AntonioVentimiglia/Buddy_Robot/README.md

# Buddy ROS 2 Robot Master Repository

This is the starter GitHub repository for **Buddy**, an autonomous ROS 2 robot using a **Jetson Orin Nano Super**, a **four-wheel differential-drive base**, **2D LiDAR**, and an **RGB-D camera**. It is designed to survive hardware changes while keeping the ROS 2 interfaces, frame tree, simulation, documentation, tests, firmware contracts, and deployment workflow organized from day one.

Two files orient everything:

- [`PROJECT_CONTEXT.md`](PROJECT_CONTEXT.md) — canonical context to paste into AI prompts; includes a "what actually builds today" table.
- [`robot_ws/SIMULATION_START_HERE.md`](robot_ws/SIMULATION_START_HERE.md) — the runbook to start modeling and torque testing right now.

Structural changes should update `PROJECT_CONTEXT.md`.

## Current design baseline

| Area | Baseline |
|---|---|
| Robot name | Buddy |
| Compute | NVIDIA Jetson Orin Nano Super |
| Robot OS target | Ubuntu 24.04 / JetPack 7.x path unless a selected driver forces another choice |
| ROS 2 target | ROS 2 Jazzy first; keep migration notes for Lyrical |
| Drive | Four-wheel differential drive / skid-differential style with left and right wheel groups |
| Sensors | 2D LiDAR, RGB-D camera, IMU, wheel encoders |
| Low-level control | Dedicated drive MCU; Linux/ROS requests motion but MCU enforces watchdog and safety |
| Navigation | Nav2, SLAM Toolbox or AMCL, robot_localization EKF |
| Simulation | Gazebo first; optional Isaac Sim/Isaac ROS path for NVIDIA acceleration |
| Future manipulation | Leave MoveIt 2-compatible arm placeholder until arm is selected |

## How to use this repository first

1. Read `PROJECT_CONTEXT.md`.
2. Requirements are answered in `TODO/01_clarifications_needed.md` and `docs/requirements/buddy_v0_1_requirements.yaml`.
3. Review `docs/system_model/frame_tree.md` and the robot model (`robot_ws/src/buddy_description/urdf/buddy.urdf.xacro`; dimensions live in `design_params.yaml` — edit it and run `python3 tools/build.py`).
4. Choose a ROS 2 + JetPack baseline in `docs/decisions/ADR-0001-ros2-jetpack-baseline.md`.
5. Start simulation before buying major hardware.

## Marking incomplete work

Everything here is in progress — filenames don't say so. When a file is a draft or
its values are unverified, put a one-line `WIP:` note at the top of the file
explaining what's missing. Decisions get locked into ADRs under `docs/decisions/`
when made; that's the signal a topic is settled, not a filename suffix.

## Repository map

```text
buddy_ros2_robot/
  PROJECT_CONTEXT.md              Canonical AI/project context
  TODO/                           Next steps, clarifications, milestone plans
  docs/                           Architecture, requirements, interfaces, power, safety, decisions
  docs/system_model/              How it fits together — start at system_integration.md
  docs/research/                  Research folders, created only when research starts
  docs/analysis/                  First-principles derivations behind every calculation
  docs/portfolio/                 Engineering log + illustrated milestone reports (website source)
  robot_ws/                       ROS 2 workspace skeleton
  firmware/                       MCU firmware architecture and starter scaffolds
  electronics/                    Generated KiCAD schematics (+ PDFs) and datasheets
  devops/                         Jetson setup, containers, systemd, udev, OTA, networking
  tools/                          Build, figures, KiCAD generators, checkers, site generator
  assets/figures/                 Generated figures — every one produced by tools/figures/
```

No diagram in this repository is drawn by hand. Figures are generated by scripts
in `tools/figures/`, schematics by `tools/kicad/`, and both are regenerated by
`python3 tools/build.py`. A hand-made architecture diagram silently contradicted
an ADR for two weeks before it was caught and deleted; see milestone M03.

## Important safety stance

The software here is a development scaffold, not a certified safety system. Physical E-stop, motor enable interruption, power fusing, current limits, watchdogs, and commissioning procedures must be implemented and tested before autonomous operation.
