AntonioVentimiglia/Buddy_Robot/firmware/drive_mcu/README.md

# Drive Mcu

Status: in progress.

Use this folder for embedded code, board notes, build instructions, pin maps, tests, and firmware update strategy.
