AntonioVentimiglia/Buddy_Robot/robot_ws/src/buddy_description/README.md

# buddy_description

Owns the robot description: URDF/Xacro, frames, visual geometry, collision geometry, inertial placeholders, sensor mounts, and future arm placeholder.

The description is the single source of truth for physical frames. Do not duplicate frame offsets in random launch files.
