AntonioVentimiglia/Buddy_Robot/docs/requirements/mission_profile(_IP).md

# Mission Profile

## Current knowns

- Main compute: Jetson Orin Nano Super.
- Drive: four-wheel differential drive.
- Sensors: 2D LiDAR and RGB-D camera.
- ROS 2 compatibility is a primary design goal.

## Fill these before buying hardware

| Domain | Answer |
|---|---|
| Indoor/outdoor/mixed | TBD |
| Floor/terrain | TBD |
| Top speed | TBD |
| Cruise speed | TBD |
| Ramp/threshold | TBD |
| Total mass target | TBD |
| Payload target | TBD |
| Runtime target | TBD |
| Arm required for v1? | TBD |
| Budget range | TBD |
| Robot max footprint | TBD |
| People/pets nearby? | TBD |
| Autonomous vs supervised | TBD |

## Notes

The mission profile drives motor torque, battery Wh, LiDAR range, camera mounting, Nav2 speed limits, base footprint, and safety architecture.
