AntonioVentimiglia/Buddy_Robot/docs/portfolio/log/2026-07.md

---
title: Engineering Log — July 2026
date: 2026-07-01
type: log
tags: [mechanical, electrical, firmware, process]
summary: Repo consolidation; drive motor, wheel, power, bus, and sensor decisions (ADR-0003 to 0007); drive stack and firmware built and host-tested; system integration drawn and machine-checked; drivetrain ordered; fabrication and arm approach chosen (ADR-0008, ADR-0009).
---

# Engineering Log — July 2026

> Entries before 2026-07-11 are reconstructed from git history and are brief by
> nature; same-day logging starts 2026-07-11.

## 2026-07-01 — June sign-off *(reconstructed)*
**Tags:** process
- Closed out June: repo scaffold, URDF model working in RViz, Gazebo sim with
  diff-drive + 2D LiDAR bridged, first torque sweep tool written.

## 2026-07-02 — BOM recovery *(reconstructed)*
**Tags:** process, failure
- BOM spreadsheet had to be recovered (`bom recovery`, commit 61925a9). Lesson:
  binary xlsx in git has no meaningful diffs — a corrupted or clobbered save
  loses history. Mitigation going forward: commit after every BOM edit.

## 2026-07-03 — Purchased bench power supply *(reconstructed)*
**Tags:** purchase
- Bench power supply bought and logged in `docs/financials/Buddy_BOM.xlsx`
  (commit 9196f51). Enables current-limited first power-up per the safety TODO.

## 2026-07-06 — Purchased Jetson peripherals *(reconstructed)*
**Tags:** purchase
- Adapters, HDMI cables, thumb drive for Jetson Orin Nano Super bring-up
  (commit 462d194). Jetson is flashed and running JetPack/Ubuntu.

## 2026-07-11 — Repo declutter, motor sizing, and ADR-0003
**Tags:** calc, decision, process
- **Declutter:** cut the repo from 227 to 106 tracked files — deleted ~19
  template-only research folders, 7 stub ROS packages, duplicate requirements
  files. Removed the `(_IP)` filename convention entirely (files are always in
  progress; the suffix broke path references). Drafts now carry an in-file
  `WIP:` note; an ADR marks a topic settled.
- **Motor sizing (calc):** built the per-wheel torque envelope for the 20 kg
  skid-steer base (r = 0.06 m, 4 driven wheels). Key finding: **pivot-in-place
  tire scrub on carpet sets the stall requirement** — 2.9–3.8 N·m/wheel at
  μ = 0.6–0.8, well above the worst straight-line case (1.47 N·m at 5° ramp +
  0.5 m/s² with SF 2.0). The existing `torque_sweep.py` didn't model scrub;
  derived it from the resisting yaw moment about the pivot center.
  Figure: `assets/figures/torque_envelope.svg`.
- **Decision:** 4× goBILDA 5203 Yellow Jacket 26.9:1 (223 RPM, 3.73 N·m stall,
  $54.99 ea) — the only shortlisted motor clearing the pivot band. Pololu 37D
  (2.65 N·m) and DDSM115 hub servos (2.0 N·m) fall inside/below it. Recorded in
  `docs/decisions/ADR-0003-drive-motor-selection.md` (Proposed; purchase pending).
- **Tension logged:** $220 of the $300–600 budget on motors collides with
  LiDAR + RGB-D + battery (design conflict #4). Fallback documented: cut gross
  mass toward ~10 kg and rerun with JGB37-520-class motors.
- **Portfolio system established** (this log, milestone reports, figures-as-code
  convention in `docs/portfolio/README.md`). Milestone report M01 written.
- **Wheel selection (decision + calc):** caught that the 0.06 m wheel radius used
  in sizing was an unsourced URDF placeholder. goBILDA traction wheels max out at
  96 mm; selected **4× Hogback 96 mm** (crowned tread purpose-built to reduce
  skid-steer scrub — directly attacks our dominant load case) + 8 mm REX hubs,
  ~$76 all-in (ADR-0004). At r = 0.048 m: design case 1.47 → 1.18 N·m, pivot band
  2.29–3.05 N·m → 22% stall margin at μ = 0.8 (was marginal). Trade accepted:
  **ground-clearance requirement amended 0.05 → 0.038 m** (the 0.05 was a round
  guess; indoor thresholds are 5–20 mm). Cascade: requirements yaml, URDF params
  (incl. base_center_z 0.10 → 0.088 to keep axle height = wheel radius so sim
  wheels touch ground), envelope figure + CSV regenerated, derivation doc
  substitutions redone, M01 postscript. Lesson: a "placeholder" number that feeds
  a real decision isn't a placeholder — audit inputs for unsourced values.
- **Parametric build system (process):** identified that design values lived in
  five hand-synced places (requirements yaml, xacro, CLI defaults, figure
  constants, markdown prose) — today's wheel change required manually chasing
  every substitution, and a hand-rounding error (3.06 vs computed 3.05 N·m) had
  already crept in. Built the fix: `design_params.yaml` (choices/assumptions) +
  requirements yaml (requirements, no overlap) → `buddy_calcs/` loader+equations
  → everything downstream is generated by `python3 tools/build.py`: the URDF
  params file (now marked GENERATED), the derivation docs (marimo notebooks in
  `docs/analysis/*.py` whose substituted numbers are computed, exported to the
  committed `.md`), both figures, and the sweep CSV. Verified end-to-end: changed
  SF 2.0 → 1.5, one build propagated 1.18 → 0.88 N·m through derivation, figure
  legend, annotation, and CSV; reverted cleanly; consecutive builds are
  byte-identical. Bonus catch: the FBD had been drawing wheels at the stale
  120 mm — parametrization fixed it automatically. Lesson: numbers that appear
  in more than one file need a build step, not discipline.
- **Derivation convention added** (same day, after review): calculations must be
  presented as checkable derivations — governing equations, symbol tables, numeric
  substitution, units check, limits of validity — so a reviewing engineer can
  verify every number by hand. First instance:
  `docs/analysis/drive_torque_and_pivot_scrub.md`, with a two-panel free-body
  diagram figure (`tools/figures/plot_drive_fbd.py`) covering the ramp FBD and the
  pivot moment balance.

## 2026-07-14 — Battery re-sized for the future dual-arm version
**Tags:** decision, calc
- **Correction of course:** the roadmap adds two 6-DOF arms in a later version
  sharing the main battery; an 8 Ah pack bought for v0.1 would be wasted money
  when the arms arrive. Amended ADR-0005 (still Proposed — nothing purchased,
  so an in-place dated amendment, not a new ADR).
- **Provision, explicitly a placeholder:** 12 XM430-class joints, ≤4 loaded per
  arm at once → +45 W average, +10 A peak, recorded in
  `design_params.yaml → power.future_arms` with instructions to replace with
  real servo specs at arm selection.
- **New spec:** designed peak 37 → **47 A** incl. arm branch → BMS ≥ **50 A**,
  main fuse 50 → **60 A** slow-blow, bus wiring upgraded to 8 AWG, future arm
  branch separately fused at 15 A. Battery ≥ 8 Ah → **≥ 14 Ah (~155 Wh),
  $100–140** — C-rate still mild (3.4C). Bonus: v0.1 runtime at expected load
  grows to ~90+ min. Mass +0.6–0.8 kg absorbed by the 20 kg ceiling — no drive
  re-sizing triggered (checked, not assumed: the envelope uses the ceiling).
- Cascade: requirements yaml (`manipulation_future`), power model + build
  validators (now check BMS/fuse against the arms-inclusive peak), notebook,
  figure (new "+ dual arms" scenario bar and third energy stack), shopping list
  (total ~$540 → **~$590**), PROJECT_CONTEXT, site chips.

## 2026-07-16 — Motor datasheet arrives, catches a 4× odometry bug
**Tags:** failure, calc, build
- **The bug:** the motor spec sheet states *"Encoder Shaft: 28 Pulses per
  Rotation (7 Cycles)"* — 28/7 = 4, so goBILDA's "pulses" are **already
  4x-decoded quadrature counts**. My code, built from the vendor web page's
  "751.8 PPR", multiplied by 4 again → 3007 counts/rev instead of **753.2**.
  Odometry would have reported ~¼ of true distance. On bench day this would
  have looked like a baffling scale error and cost hours; the datasheet cost
  ten minutes.
- **Root cause is naming, not arithmetic:** "PPR" is ambiguous (pulses? cycles?
  edges?) and I resolved it the conventional way instead of checking. Fix
  renames the parameter to `encoder_counts_per_rev_output` so the unit is
  unambiguous at every call site, with the datasheet quote in the comment.
  Corrected in design_params, the generated firmware header, `base_core.py`,
  both test suites, and the mock MCU's wheel model; all 6 suites still green.
- **Caught a vendor error too:** the sheet's companion "(134.4 Cycles)" is
  inconsistent — 753.2/134.4 = 5.6, not 4, and 134.4 = 7 × **19.2**, the *other*
  gear ratio's number. Our value (28 × 26.9 = 753.2) is self-consistent. Flagged
  in the yaml comment; empirical check added to bench day (one wheel revolution
  by hand, read the count).
- **Confirmed by the same sheet:** no-load current **0.25 A** — exactly the
  estimate the power budget assumed and flagged for measurement (ADR-0005). One
  assumption closed, no change needed.
- **Harness gap found while purchasing:** connectors/cabling for the motors were
  never in the shopping list. Wrote `docs/system_model/wiring_harness.md`
  documenting goBILDA's MH-FC/FH-MC gender notation, the motor's two interfaces
  (3.5 mm bullets FH-MC for power; 4-pos JST XH FH-MC for the encoder), and —
  most importantly — that **motor power goes to the driver, never to the
  Nucleo**. Correct part is the *breakout* encoder cable (4 individual Dupont
  leads), because our encoder pins are deliberately non-adjacent across
  TIM2/3/4/8. +$56 to the cart (now ~$646, or ~$741 with Phase A sensors).

## 2026-07-28 — Integration figures, and the first build that ran on Windows
**Tags:** build, test, process, failure
- **The trigger:** integration knowledge was spread across six correct documents
  and one wrong drawing. `assets/diagrams/system_architecture_mermaid.md` — hand
  made, not generated — still showed a **CAN bridge** two weeks after ADR-0006
  chose USB serial. Deleted. A drawing that isn't generated is already wrong;
  it just hasn't been caught yet.
- **Six generated figures** (`tools/figures/plot_{ros_graph, control_safety_loop,
  power_one_line, interconnect, fault_state_machine, startup_sequence}.py`),
  indexed from the new `docs/system_model/system_integration.md` and published as
  milestone M03. Matplotlib does Buddy's quantitative figures well and block
  diagrams badly, so they render through a new dependency-free SVG kit
  (`tools/figures/blockdiagram.py`); the palette moved to one file
  (`tools/figures/palette.py`) that all nine figures now import — verified
  output-neutral by regenerating the three existing figures byte-for-byte first.
- **Topology became data:** `docs/system_model/integration_map.yaml` owns what
  connects to what and is forbidden from holding a number that `design_params.yaml`
  or the requirements yaml already owns; it writes references
  (`param:power.protection.main_fuse_a`) that resolve at draw time. The fuse
  rating on the power diagram isn't a copy of the fuse rating — it *is* the fuse
  rating.
- **`tools/check_integration_map.py`** runs first in every build and asserts the
  map against `pin_map.md` ↔ `pins.h`, the KiCAD net table, `drive_protocol.md`
  (states + fault bits) and the topics `ros_bridge_node.py` really creates.
  Tested by breaking things on purpose: flipping one INA pin `PB0`→`PB9` fired
  two independent checks; renaming a fault bit fired a third. It also caught a
  real inconsistency on first run — the map claimed a `/diagnostics` publisher
  that doesn't exist yet, so the check now tolerates `planned` topics being
  absent from code while still refusing to let code publish anything the diagram
  omits.
- **Layout is audited, not eyeballed.** Every figure bounds-checks each box,
  label and edge tag against the canvas and each other before writing; caught 8
  collisions in the first ROS graph and 19 in the first interconnect. Cross-checked
  against real browser font metrics afterwards: 417 text elements, zero collisions.
- **Second KiCAD sheet** (`electronics/KiCAD/system_wiring/`): pack, protection
  chain, rails, Jetson↔MCU↔sensors, future arm branch — 16 nets asserted by
  `check_system_wiring.py` against an independently written expectation. Drawing
  it surfaced two facts no document had stated: the **LD19 is not on the 5 V
  rail** (the D300 USB adapter draws its 0.9 W from a Jetson port, so it sits in
  the Jetson's budget), and the **BNO086 is on a different 3.3 V rail** from the
  encoders (`+3V3_JETSON`, the 40-pin header, vs the Nucleo LDO's `+3V3`).
  Corrected in the map.
- **Three real bugs in the existing toolchain, all found by running it here:**
  (1) `tools/build.py` had never been run on Windows and died on the `η` in a
  derivation — `write_text` defaults to cp1252; every generator now writes UTF-8
  with explicit LF, plus a `.gitattributes` so `core.autocrlf` stops rewriting
  the generated tree. It also emitted `docs\analysis\...` backslash paths into a
  committed file. (2) The schematic generator used `uuid4()`, so regenerating an
  unchanged schematic produced 498 lines of meaningless diff; UUIDs are now
  `uuid5` of a stable key, and kicad-cli's wall-clock `/CreationDate` in the PDF
  export is rewritten to the sheet date (same byte length, xref stays valid).
  (3) `check_drive_wiring.py` hard-coded the macOS `kicad-cli` path, so the
  "machine-checked, not visually claimed" property was true on exactly one
  laptop — it now resolves across all three platforms.
- Consecutive builds are byte-identical again, now including the schematics and
  their PDFs. Lesson: "reproducible" is a claim about the machines you have
  actually run it on, and this repo had one.
- Not verified here: the C protocol/state-machine tests and the pty-backed mock
  MCU need a POSIX toolchain (no `cc`, no `termios` on Windows). The pure-Python
  suites — 9 protocol + 8 base_core — pass.

## 2026-07-31 — Drivetrain ordered; fabrication method chosen; the arms get real
**Tags:** purchase, decision, calc
- **Drivetrain ordered** (goBILDA): 4× 5203 motors, 4× Hogback wheels, 4× Sonic
  hubs, encoder breakout cables, motor power cables, M4 hardware — ~$359 with
  shipping, recorded in `Buddy_BOM.xlsx` as *Order Pending*. The 4× Pololu
  VNH5019 carriers and 2× NUCLEO-G474RE already arrived. ADR-0003/0004 are now
  decisions with money behind them and should flip Proposed → Accepted.
  *(First CAD assemblies — motor, wheel, Sonic hub, drivetrain — were committed
  the same session; that work still needs its own narrative entry from the
  author, including why the sub-assembly split was chosen.)*
- **Fabrication method decided (ADR-0008): in-house FDM printing**, and the
  printer is **QIDI Plus 4** (~$800). The interesting part is which requirement
  turned out to be binding. The instinct is to score printers on build volume
  and price; the actual driver was **chamber temperature**. Motor mounts bolt
  directly to gearboxes running at the 8 A design limit, and PLA's glass
  transition is ~60 °C — a mount that creeps there doesn't break visibly, it
  relaxes, and the symptom that reaches the operator is **drifting odometry**,
  which gets misdiagnosed as a firmware bug for weeks. That pushes the material
  to ASA/PA-CF, which at a ~280 mm part length needs an *actively* heated
  chamber, not a passive enclosure. That single requirement eliminated the
  popular defaults: the Bambu P1S (best measured accuracy in the set at
  ±0.05 mm) and the Elegoo Centauri Carbon are both passively enclosed, and the
  Prusa CORE One — the most open and best-supported machine considered — has the
  *smallest* build area of the five at the highest price.
- **Reversal worth recording:** the Centauri Carbon ($299) was the right
  recommendation an hour earlier, under a hard budget ceiling. When the owner
  scoped the printer as a capital tool for future projects, the ceiling lifted
  and the ranking inverted. Lesson: a recommendation is only as durable as the
  constraint that produced it — worth naming the constraint out loud so the
  reversal is legible instead of looking like inconsistency.
- **Arms decided (ADR-0009): printed structure + hobby servos**, forced by cost —
  Dynamixel XM430-class would be ~$3,100 for twelve joints against a $2000
  programme budget. **This decision reached back into the power architecture.**
  ADR-0005's whole argument was that stall current is a *designed ceiling*
  because the VNH5019s have an adjustable current limit. Hobby servos have no
  such limit — commanded into a stall they draw stall current until something
  else stops them. Bounded it: manipulation average ~39 W (the 45 W placeholder
  survives), realistic 8-joint peak ~11 A at the bus (10 A placeholder marginal),
  all-12-stalled ~29 A — which would have pushed the designed peak from 47 A to
  ~66 A, past both the ≥50 A BMS and the 60 A fuse.
- **The protection chain already contained it, by accident of good design.** The
  15 A arm branch fuse from the 2026-07-14 amendment caps the branch at ~166 W,
  sitting deliberately between the realistic peak (holds) and the all-stalled
  case (blows). So ADR-0005 survives unmodified and **the imminent battery
  purchase is not blocked** — checked, not assumed. What changed is the *role* of
  that fuse: specified as a backstop for actuators that limited their own
  current, it is now the primary limiter. Safe, but not graceful — the drive side
  degrades by quietly limiting torque, the arm side by blowing a fuse and
  demanding a human. Flagged for a current-limited servo rail at arm build time.
- **Budget reframed** (`design_conflicts.md` #4, revised): the $300–600 band is
  superseded by a $2000 programme budget split into pots — $1,173.85 spent,
  $826.15 left, v0.1 needs ~$355 of it, future-phase (OAK-D + arm servos)
  ~$380–560. v0.1 closes comfortably; the roadmap closes only at the low end of
  the servo estimate. That makes the ADR-0009 open item — evaluate Feetech
  STS/SCS bus servos, which would buy back both position feedback and current
  limiting at near hobby-servo cost — a budget decision as much as a technical one.
- Research doc: `docs/research/hardware/fabrication/printer_selection.md`
  (six requirements derived from the robot, five candidates scored, known
  limitations of the selected machine listed rather than discovered later —
  including that its effective *heated* build height is ~268 mm, not 280).

## 2026-07-31 — Jetson bring-up: ROS 2 on the robot computer, drive stack verified
**Tags:** build, test, failure
- **The zero-hardware milestone is real, on the actual robot computer.** ROS 2
  Jazzy installed, workspace built (3 packages, 5.5 s), and the full chain
  proven: `/cmd_vel` → `buddy_base` bridge → real protocol bytes over a pty →
  mock MCU state machine + wheel model → telemetry → `/odom`. **9/9 checks pass.**
- **Numbers, not vibes:** commanded 0.2 m/s, reported steady-state velocity
  0.2008 m/s (**0.4% error**), independently measured over a timed window
  0.1952 m/s (**2.4%**). Commands stopped → position held, confirming the 200 ms
  watchdog (REQ_SAFE_002) end-to-end through the real bridge rather than a unit test.
- **First time the C toolchain ran anywhere but a dev machine.** The 07-15 entry
  noted the C protocol and state-machine tests couldn't run on Windows (no `cc`,
  no `termios`). On the Jetson they run: 11 C protocol, 20 C state machine,
  Python protocol, mock MCU self-test, 8 BaseCore units, 5 integration — all green.
- **Failure 1 — the setup script had never been run end to end.** It opens with
  `set -euo pipefail`, and ROS's own `/opt/ros/jazzy/setup.bash` reads variables
  it never sets (`AMENT_TRACE_SETUP_FILES`). Under `-u` that is fatal, so the
  script died at step 3/6 — *after* a 15-minute apt install, on the first line
  that costs nothing. Fixed with `set +u` around both `source` calls. Lesson: a
  script that has only ever been read is not a script that works, and the
  expensive steps passing tells you nothing about the cheap ones.
- **Failure 2 — Python buffering hid the handoff.** The mock MCU prints its pty
  path; with stdout redirected to a file that print is block-buffered and never
  arrives, so the verification script couldn't find the device it had just
  created. `python3 -u`. Invisible in interactive use, fatal in automation.
- **Failure 3 — the test was wrong, not the code.** First verification run
  reported the robot travelling 0.378 m where 0.2 m/s × 3 s predicts 0.6 — a 37%
  shortfall that looks exactly like a scaling bug, which is the same *shape* as
  the 4× encoder bug found on 07-16. It wasn't: node startup, DDS discovery, the
  SAFE_IDLE→ARMED→ACTIVE transition and the mock's wheel ramp all landed inside
  the measurement window. Rewritten to measure **steady-state velocity** instead
  of integrating across startup, which is both the correct measurement and the
  one that actually says whether the stack tracks its command. Worth recording
  because the tempting move was to go hunting in the kinematics.
- **Automation path built** (`devops/jetson/`): key-based SSH from the Mac, plus
  `sudoers-buddy-setup` — a narrow NOPASSWD drop-in scoped to apt/dpkg/locale-gen/
  rosdep/udevadm with `cp` **pinned** to `/etc/udev/rules.d/`, since an unpinned
  `sudo cp` is arbitrary root file-write and would make the other restrictions
  decorative. The file states plainly that it is not a security boundary — `apt
  install` as root is arbitrary code execution by definition — and can be deleted
  after bring-up, because nothing in the daily workflow needs sudo at all.
- Verifying the NOPASSWD paths *before* the long run caught `udevadm` at
  `/usr/bin/`, not `/usr/sbin/` as assumed. A wrong path there doesn't error —
  sudo silently falls through to prompting, which hangs an unattended run.
- **New artifact:** `devops/jetson/verify_zero_hardware_stack.sh` — the milestone
  as a repeatable script with written pass/fail criteria, rather than three
  hand-driven terminals and an eyeball.

## 2026-07-31 — First silicon: firmware flashed, link verified, 0.49 ms round trip
**Tags:** build, test, failure
- **The firmware runs on real hardware for the first time.** Flashed a
  NUCLEO-G474RE from the Jetson over SSH; `st-flash` verified the write. The
  board self-identified as `STM32G47x_G48x`, 512 KiB flash, ST-LINK **V3J16** —
  vendor:product `0483:374e`, exactly what `99-buddy-robot.rules` assumed, so
  `/dev/buddy_drive_mcu` appeared on first plug-in. One assumption that could
  have been wrong wasn't.
- **Link verified end to end** (`devops/jetson/verify_drive_mcu_link.py`, 13/13):
  telemetry at **102.0 Hz** against a 100 Hz target, **zero CRC errors** and zero
  version errors across 204 frames, state `SAFE_IDLE` with no fault bits, wheels
  reporting zero velocity, and PING→PONG **10/10** reporting firmware v0.1.0 /
  protocol v1 — the version gate of `drive_protocol.md` rule 4 exercised for real.
- **First measured latency on the real link: 0.48–0.61 ms round trip**, median
  0.49 ms. The 07-14 interface verification argued this on paper (18× bandwidth
  margin); measured, the margin against the 200 ms watchdog is ~330×. The
  watchdog budget is not remotely the constraint on this bus.
- **Build reproducibility, unplanned evidence:** the committed `firmware.bin`
  was dated 14 July. A clean rebuild three weeks later on a different machine
  produced a byte-identical image (md5 `b768497a…`). Checked before flashing
  rather than trusting the timestamp — flashing a stale image is a bug that
  hides for days.
- **Failure — a permissions trap that would have been misdiagnosed.** The udev
  rule creates `/dev/buddy_drive_mcu` as `root:dialout 0660`, and the `dialout`
  group on the Jetson was **empty** — `venti` was not a member. The symlink
  exists, the rule "works", and the bridge still cannot open the port. The
  obvious suspect would have been the udev rule, which was innocent. Fixed with
  `usermod -aG dialout`; worth knowing that a fresh SSH session is needed for the
  new group to apply.
- **Failure — my test was wrong, not the firmware. Again.** First run reported
  PING→PONG 0/10 and I went hunting in the HAL: checked `volatile` on the RX ring
  (correct), noticed there is no `HAL_UART_ErrorCallback` and theorised that a
  DTR transient on port-open latched a UART error and killed RX permanently.
  A controlled experiment — quiesce DTR/RTS, reset the MCU with the port already
  open, re-ping — returned 5/5 both before and after, refuting it. The actual
  cause: my script asserted `PONG.seq == PING.seq`, but `drive_protocol.md`
  defines the PONG payload as `{fw_major, fw_minor, fw_patch, protocol_version}`
  and specifies **no seq echo**; the MCU stamps its own TX seq, and only
  `TELEMETRY.cmd_seq_echo` echoes, only for CMD_VEL. The firmware was right and
  the spec was unambiguous.
- **Second-order bug in the same test:** the "round trip" initially measured
  99–111 ms, which looked like a real latency problem. It was `ser.read(512)`
  refusing to return until 512 bytes accumulated — at ~4.7 kB/s of telemetry
  that is ~110 ms of pure measurement artefact. Reading `in_waiting` instead
  moved the number to 0.49 ms. **Two tests in one day where the instrument, not
  the system, was the thing under test.** The pattern to internalise: when a
  measurement disagrees with a design estimate by two orders of magnitude,
  suspect the measurement first — it is cheaper to falsify.
- Note for the bench phase: the `HAL_UART_ErrorCallback` gap is real even though
  it was not today's bug. Nothing currently re-arms `HAL_UART_Receive_IT` after
  a UART error, so a single overrun would silently kill RX while telemetry keeps
  streaming — a failure that looks like a dead Jetson link, not a dead MCU.
  Logged as a bench TODO rather than fixed blind.
- **New artifacts:** `tools/flash/flash_drive_mcu.sh` (was a stub that printed
  "not configured yet" and exited 1) and `devops/jetson/verify_drive_mcu_link.py`.

## 2026-07-31 — Bridge meets real silicon, and finds a latched-fault bug
**Tags:** build, test, failure, decision
- **Closed the gap I had left open:** the `buddy_base` bridge had only ever
  talked to `mock_mcu.py` over a pty. Pointed the same code path at
  `/dev/buddy_drive_mcu` (`devops/jetson/verify_bridge_vs_real_mcu.sh`).
  Safe by construction — no drivers wired, no motors attached, and the MCU
  refuses motion without an explicit ARM.
- **The full chain works on hardware:** bridge opens the real port, parses real
  telemetry into `/odom`, `/joint_states` and `/battery_state` (1.26 V — a real
  ADC reading, not a mock constant), auto-arms off a genuine `SAFE_IDLE`, and
  the MCU reports **`cmd_seq_echo=71`** — seventy-one CMD_VEL frames that began
  life as ROS `/cmd_vel` messages, accepted by the real state machine. The
  200 ms watchdog then fired on silicon: `fault_bits=0x0002`, REQ_SAFE_002
  verified on hardware rather than in a unit test.
- **Bug 1 — the bridge cried wolf.** It logged every `FAULT_EVT` at WARN as
  "MCU fault event". But `FAULT_EVT` is emitted on *any* state transition —
  `main.c` sends it whenever state or fault_bits change, and
  `drive_protocol.md` documents it as "on transition". The first real run
  duly reported two "faults" that were the benign `SAFE_IDLE → ARMED` handover
  with `bits=0x0000`. Left alone, the bench phase would have been wall-to-wall
  spurious warnings and a real fault would have been invisible among them. Now
  WARN only when a bit is actually set, INFO otherwise. Fixed a second defect in
  the same handler: it logged `core.state_name()` — whatever the last telemetry
  frame happened to say — rather than the state carried in the event payload
  that the transition was actually about.
- **Bug 2 — a real firmware bug, and the interesting one.** `sm_tick` carries
  the comment *"per state_machine.md: timeout is a recoverable stop, not a
  latched fault"* and correctly drops to `SAFE_IDLE` instead of `FAULT`. But it
  sets `BP_FAULT_CMD_TIMEOUT` and **nothing anywhere clears it**:
  `MODE_CLEAR_FAULT` only acts in `FAULT` state, which the watchdog
  deliberately never enters. The bit was unreachable for the life of the MCU.
  The implementation contradicted its own stated design intent, one line above.
- **How it surfaced:** the second hardware run inherited `0x0002` from the
  first and reported it in ARMED *and* ACTIVE. A stale flag from a previous
  session was masquerading as a live fault — and a genuinely new timeout would
  have been indistinguishable from it. This is invisible to host tests that
  start from `sm_init`, which is precisely why it survived 20 passing state
  machine checks.
- **The codebase already knew the right answer:** `sm_set_estop` clears its own
  bit when the condition goes away. CMD_TIMEOUT now follows the same pattern —
  cleared on re-ARM and on any accepted CMD_VEL. Only that bit; real faults
  still demand CLEAR_FAULT from FAULT state.
- **Written test-first:** added four host assertions, confirmed **2 failed**
  against the old firmware, then fixed. `mock_mcu.py` had the identical bug —
  it mirrors the C state machine faithfully, defect included — so it got the
  same fix, keeping the two implementations in lockstep. That lockstep is the
  whole reason the protocol was implemented twice.
- **Verified by repetition, not assertion:** ran the hardware check twice in
  succession. Run 1 leaves a watchdog timeout behind; run 2 came up clean
  (`0 faults`, reached ARMED). Firmware 16400 → 16416 bytes.
- **A third instrument correction:** `verify_drive_mcu_link.py` asserted
  `fault_bits == 0`, which quietly assumed a freshly booted MCU and failed the
  moment it ran after a bridge session. Now masks the recoverable CMD_TIMEOUT
  and fails only on latching bits — encoding the distinction the firmware fix
  made explicit.
- Final state: MCU link 13/13, bridge-vs-real-MCU 13/13 (twice), zero-hardware
  stack 9/9, full host suite green on the Jetson.

## 2026-07-16 — KiCAD harness schematic, generated and machine-verified
**Tags:** build, test
- **Wiring diagram as code:** `tools/kicad/gen_drive_wiring.py` emits a native
  KiCAD 10 schematic (`electronics/KiCAD/drive_mcu_wiring/`) — NUCLEO-G474RE
  block, 4× VNH5019, 4× motor/encoder units, Vbat divider, power/E-stop notes —
  with connectivity by named nets matching `pin_map.md`/`pins.h`. Opens in the
  user's KiCAD; renders via `kicad-cli`.
- **Connectivity is checked mechanically, not visually:**
  `tools/kicad/check_drive_wiring.py` exports the netlist through kicad-cli and
  asserts all 43 nets pin-by-pin (every MCU pin to its exact driver/encoder
  counterpart, power rails counted). Two real bugs found and fixed in the
  process: caption offsets landing near neighboring blocks, and off-grid pin
  endpoints (instance origins must sit on KiCAD's 1.27 mm grid).
- The schematic is documentation of the harness; electrical *spec* checks
  (voltage levels, AF mappings, ADC ranges) live in
  `docs/system_model/electrical_interfaces.md` — the drawing now gives them a
  buildable wiring reference.

## 2026-07-15 — The drive stack exists end-to-end (no hardware yet)
**Tags:** build, test, decision
- **`buddy_base` bridge written and proven:** all drive logic (skid-steer
  kinematics with ratio-preserving clamp, diff-drive odometry with midpoint
  integration, keep-alive pacing against the 200 ms MCU watchdog) is plain
  Python with no ROS dependency — 8 unit tests + **5 end-to-end integration
  tests driving the mock MCU through real protocol bytes**: straight-line and
  pivot odometry within model tolerance, watchdog stop with bounded runaway
  distance, E-stop visibility, joint states. The rclpy node is a thin shell;
  `base.launch.py` is now real. Deleted the stale CAN/C++ stubs and configs
  that carried wrong geometry (0.08 m wheels — exactly the drift the
  parametric system exists to kill; geometry now flows from `design_params.yaml`).
- **Testing found a real bug:** the mock MCU used wall-clock time for its
  watchdog, so simulated-time tests couldn't trip it. Now takes an injectable
  clock — the same pattern the C state machine had from the start. Lesson: the
  C core got it right *because* it was designed for host testing; the mock was
  written casually and paid for it.
- **Sensors selected, phased (ADR-0007):** LD19 LiDAR ($70, 0.9 W, ToF 12 m) +
  BNO086 IMU ($25, on-chip fusion) join the current order (+$90 → ~$685);
  OAK-D Lite ($140, 4.5 W, on-camera VPU) selected but deferred until
  perception work starts. Budget extension past the $300–600 band made
  explicit in the ADR. The power reserves held without amendment — the
  reserve mechanism did its job.
- **Jetson bring-up scripted** (`devops/jetson/setup_ros2_jazzy.sh`, idempotent):
  ROS 2 Jazzy + workspace build + the full host test suite, ending at the
  **zero-hardware milestone** — teleop keyboard → bridge → mock MCU → `/odom`
  on the actual robot computer. Real udev rule written for the ST-LINK VCP
  (0483:374e → `/dev/buddy_drive_mcu`).
- **M02 milestone report** published: the stall-current story, the validator
  catch, and the size-once-for-the-arms battery decision.

## 2026-07-14 — Interface verification, drive protocol v1, firmware compiles
**Tags:** calc, decision, build, test
- **Interface verification** (`docs/system_model/electrical_interfaces.md`):
  purchases proceed on the assumption motors ↔ VNH5019 ↔ G474 ↔ Jetson
  interoperate — now checked signal-by-signal with numbers instead of hope.
  Highlights: everything is 3.3 V-native (VNH5019 logic high ≥ 2.1 V), zero
  level shifters; TIM1 @ 170 MHz → 20 kHz PWM at ~13-bit resolution; CS gives
  1.12 V at the 8 A limit into a 12-bit ADC (~5.8 mA/LSB); VCP link has 18×
  bandwidth margin; MCU powered from the 5 V rail so both failure directions
  (Jetson dies / MCU dies) land safe. Five-item bench-verify list for what
  paper can't close.
- **ADR-0006 — bus decision:** USB serial via the Nucleo's ST-LINK VCP for
  v0.1 (zero hardware, huge margin); CAN-FD reserved for the arm era (G474 has
  FDCAN on-chip); micro-ROS rejected because the MCU must stay safe with ROS
  entirely absent.
- **Drive protocol v1, implemented twice on purpose:** framed 0xB5DD +
  CRC-16/CCITT-FALSE + seq + version; CMD_VEL/CMD_MODE/PING/TELEMETRY/PONG/
  FAULT_EVT; 200 ms watchdog rule (REQ_SAFE_002); E-stop dominance; MCU-side
  velocity clamp. C implementation (no deps, no allocation, resynchronizing
  parser) compiles into firmware AND host tests; Python mirror for the Jetson
  bridge; **golden vectors assert byte-identity between the two** — the ends
  cannot drift silently.
- **Mock MCU** (`mock_mcu.py`): full state machine + watchdog + wheel model
  over a pty — the future `buddy_base` bridge node gets integration-tested with
  zero hardware. 10 behavioral self-tests pass.
- **Firmware compiles for the real target:** pure-C safety state machine
  (host-tested: 19 checks incl. "E-stop release does not auto-run" and "cannot
  arm out of FAULT"), HAL layer per the new pin map (4 hardware quadrature
  timers, TIM1 PWM, CS ADC, fault GPIOs), superloop with telemetry at 100 Hz.
  PlatformIO/GCC for NUCLEO-G474RE: **16.4 kB flash, 1.5 kB RAM**. Firmware
  constants (`buddy_config.h`) are GENERATED from `design_params.yaml` — the
  parametric build now reaches into the firmware.
- One command runs every host-side test: `tools/run_protocol_tests.sh`
  (C protocol, C state machine, Python protocol, mock MCU — all green).
- Lesson: writing the protocol twice with golden vectors caught nothing today
  *because it can't* — mismatches are structurally impossible to ship. That's
  the point.

## 2026-07-12 — Power budget: the stall-current fear, resolved by design
**Tags:** calc, decision
- **The fear:** 4 × 9.2 A motor stall + Jetson + sensors looked like an
  impossible/unaffordable battery worst case. **The resolution:** stall current
  is a fault condition, not an operating point — the motor drivers' adjustable
  current limit turns the worst case into a *chosen* number. Designed ceiling:
  8 A/motor → 37 A bus peak including system loads, vs 42 A unlimited fault.
- **The validator earned its keep on first run:** the initial 7 A limit choice
  only allowed 2.81 N·m — below the 3.05 N·m worst-case carpet pivot. Raised to
  8 A (allows 3.23 N·m) and scaled the protection chain to match (BMS ≥ 40 A,
  fuse 50 A). `tools/build.py` now enforces these inequalities on every build
  (`buddy_calcs/power.py::validate`).
- **Architecture (ADR-0005):** 3S Li-ion + BMS (chosen over RC LiPo for the
  hardware protection layer near people/pets); motors direct on the bus; Jetson
  behind a regulated 12 V buck (dev kit input 9–20 V verified — sag can't brown
  out compute); protection chain driver-limit → BMS → 50 A slow-blow fuse → E-stop.
- **Capacity:** unchosen camera/LiDAR carry ≤ 5 W *reserved allocations* that
  become hard selection constraints. Allocation model (everything at full
  reserve): 66 W avg → 92 Wh → **3S ≥ 8 Ah, ~$60–100** guarantees the 60-min
  requirement; expected usage (46 W) gives ~85 min. Peak is a mild ≈ 4.5C —
  the peaks never drove the sizing; runtime did.
- New parametric analysis: `design_params.yaml` power section +
  `buddy_calcs/power.py` + `docs/analysis/power_budget_and_battery.py` notebook +
  `assets/figures/power_budget.svg`. Superseded and deleted the all-TBD
  `docs/hardware/power_budget.yaml` and `tools/calculators/battery_sizing.py`.
- **Carried forward:** motor driver selection now has a HARD requirement —
  adjustable ~8 A per-channel current limit (in-driver or current-sense + MCU).
- **Motor driver shortlist (decision pending purchase):** compared RoboClaw
  2x15A (premium, $260), TB67H420FTG (hardware current chop but 3.4 A continuous
  — only 10% over the 3.1 A sustained case, thermally thin), BTS7960 ($35,
  crude), and **4× Pololu VNH5019 carriers (~$100, recommended)** — 12 A/30 A
  per channel, 140 mV/A current-sense into the G474's ADCs for the 8 A firmware
  limit, hardware overcurrent backstop. The firmware limit sits on the safety
  path → mandatory bench verification before rolling. Bonus: the dual-VNH5019
  Arduino shield stacks directly on the NUCLEO-G474RE for the first bench loop.
  Doc: `docs/research/hardware/electronics/motor_drivers/driver_selection.md`.
- **Purchasing checklist created:** `docs/financials/SHOPPING_LIST_v0_1.md`
  (temporary) — full v0.1 cart ≈ **$540** of the $300–600 budget: drivetrain
  $292, electronics + power $249. Conflict #4 quantified, trim options listed.
- **Portfolio website generator built** (`tools/site/build_site.py`, runs inside
  the parametric build): renders milestones, analyses (KaTeX math), ADRs, and
  this log into `site/` — 10 pages, engineering-clean light design sharing the
  figure palette so figures blend into the page, landing-page spec chips
  **computed from `design_params.yaml` at build time** (the website is itself a
  parametric artifact). Verified in-browser: zero KaTeX errors across 13 display
  equations, all figures load, no broken links (unmapped repo docs render as
  code, not 404s). Kept private/local for now; deterministic + committed like
  all generated artifacts.
