AntonioVentimiglia/Buddy_Robot/devops/networking/network_plan.md

# Networking Plan

- Robot hostname: `buddy.local` placeholder.
- Use SSH keys.
- Keep a local recovery account.
- Use wired Ethernet for development when possible.
- Wi-Fi is convenience, not the only recovery path.
- Decide whether VPN/private remote access is allowed.
- Keep ROS_DOMAIN_ID fixed per robot/test environment.
