AntonioVentimiglia/Buddy_Robot/robot_ws/src/buddy_simulation/docs/simulation_plan.md

# Simulation Plan

## Level 1 - Interface simulation

Nodes start, topics connect, TF tree exists.

## Level 2 - Physics simulation

Differential drive moves, simulated LiDAR publishes scan, odometry publishes.

## Level 3 - Navigation simulation

Nav2 completes a route in a simple world.

## Level 4 - Hardware-in-the-loop later

Real MCU is connected while robot motion is constrained or simulated.
