AntonioVentimiglia/Buddy_Robot/docs/portfolio/README.md

# Portfolio System

**The website is live-generated:** `tools/site/build_site.py` (runs inside
`python3 tools/build.py`) renders this folder + `docs/analysis/` + the ADRs into
`site/` — engineering-clean light design matching the figures, KaTeX math,
landing-page spec chips computed from `design_params.yaml`. View locally:
`python3 -m http.server -d site 8137`. Publish decision deferred (portable
relative paths; GitHub Pages-ready).

This folder is the source material for the eventual project website and for
defending Buddy's engineering decisions in interviews. The repo stays private;
the website is **generated from these documents**, so their structure is a
contract — keep it consistent.

## The three layers

| Layer | Where | Cadence | Purpose |
|---|---|---|---|
| **Engineering log** | `log/YYYY-MM.md` | every working session | Raw record: what was done, numbers, failures, lessons. 5–10 lines per entry. This is where "tell me about a time something didn't work" gets answered. |
| **Milestone reports** | `milestones/Mxx-*.md` | one per completed phase | Polished, illustrated narrative synthesized from log entries + ADRs + research docs. These become website pages. |
| **Decision/analysis records** | `docs/decisions/` (ADRs), `docs/research/` | as decisions happen | The technical substance the other two layers cite. Not duplicated here. |

## Rules

1. **Every milestone report gets at least one figure**, and every figure is
   generated by a script in `tools/figures/` — never a screenshot of a hand-made
   chart. Figures regenerate from the repo; a figure that can't be regenerated
   from committed code doesn't go in a report.
2. **Every calculation states its assumptions with justification and a
   sensitivity note** ("if μ is 0.8 instead of 0.6, the requirement is 3.8 N·m —
   still covered"). Interviewers attack assumptions, not arithmetic.
3. **Every calculation is presented as a derivation, not a result.** A reviewing
   engineer must be able to check every number with a calculator: governing
   equations from first principles (with a free-body or kinematic diagram where
   forces/moments are involved), a symbol table with units and the values used,
   the numeric substitution written out, a units check, and explicit **limits of
   validity** (the conditions under which the model stops being true). Derivations
   live in `docs/analysis/`, one document per calculation domain; research docs
   and milestone reports *cite* them rather than restate them. The tone target:
   explaining the process, never presenting a number to be taken on faith.
   **Mechanically**, each derivation is a marimo notebook (`docs/analysis/*.py`)
   whose substituted numbers are computed from `design_params.yaml` +
   the requirements yaml via `buddy_calcs` — explore live with
   `marimo edit <notebook>.py`; `python3 tools/build.py` exports the committed
   `.md` (a generated artifact) and regenerates figures, the URDF params, and
   data files in the same pass. A derivation can never silently disagree with
   the parameters again.
4. **Physical evidence is captured the day it happens** in
   `assets/evidence/YYYY-MM-DD_slug/` (photos, videos, scope traces, test CSVs).
   Hardware states are unrepeatable — the bare chassis can't be re-photographed
   after it's wired.
5. **Log entries are written same-day**, even if only three lines. Backfilled
   entries are marked as reconstructions.
6. **Frontmatter on every log file and milestone report** (website generation
   depends on it):

```yaml
---
title: <page title>
date: YYYY-MM-DD
type: milestone | log
tags: [mechanical, process, embedded, testing, ...]
summary: <one sentence for index/card pages>
figures: [assets/figures/<name>.svg]   # milestones only
---
```

## Log entry format

```markdown
## YYYY-MM-DD — Short title
**Tags:** calc | decision | build | test | failure | purchase
- What was done, with numbers.
- What went wrong / what was learned (most valuable line — don't skip).
- Links: ADRs, research docs, evidence folders, commits.
```
