AntonioVentimiglia/Buddy_Robot/docs/financials/Buddy_BOM.xlsx

Descriptive Part Name | Total Qty Required | Qty Purchased | Unit Cost | Total Spent | Part Status | Date Ordered | Date Received | Vendor | Vendor’s Part # | Manuf. | Manuf. Part # | Key Features / Specs | URL | Shipping Link / ID | More Info | Legend
Jetson Orin Nano Super | 1 | 1 | $268.30 | $268.30 | Received/Delivered | 2026-06-28 | 2026-07-06 | NVIDIA | - | NVIDIA | - | SBC | https://marketplace.nvidia.com/en-us/enterprise/robotics-edge/jetson-orin-nano-super-developer-kit/ | https://marketplace.nvidia.com/en-us/account/?action=order_status | > AI Performance: 67 TOPS > GPU: NVIDIA Ampere architecture with 1024 CUDA cores and 32 tensor cores > Power: 7W-25W |  | = Cell calculated from Formula
KingSpec NVMe SSD | 1 | - | $56.97 |  | N/A |  |  | Amazon | B0D1R7HDJF | KingSpec |  | SSD 256GB, M.2 NVMe Gen3x4 SSD 2280 | https://www.amazon.com/KingSpec-256GB-NVMe-Gen3x4-2280/dp/B0D1R7HDJF |  | Up to 2400MB/s, Internal Solid State Drive with 3D NAND Flash, Compatible with Desktop and Laptop
Soldering Iron Kit Electronics, 14-in-1 60w Adjustable Temperature Soldering Iron, 5pcs Soldering Iron Tips, Desoldering Pump, Tweezers, Stand, Solder, PU Carry Bag | 1 | 1 | $24.99 | $24.99 | Received/Delivered | 2026-06-29 | 2026-07-02 |  |  |  |  |  | https://vilros.com/products/vilros-soldering-iron-kit-electronics-14-in-1-60w-adjustable-temperature-soldering-iron-with-on-off-switch-5pcs-soldering-iron-tip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 | https://vilros.com/checkouts/cn/hWNDusRMj6K85SvbVymcHVwX/en-us/thank-you?skip_shop_pay=true |  | Purchase Status Drop Down List Options
MicroSD Card (32 GB) | 1 | - |  |  | Already Owned |  |  |  |  |  |  |  |  |  |  | Already Owned
MicroSD to USB-B to USB-A | 1 | - |  |  | Already Owned |  |  |  |  |  |  |  |  |  |  | Received/Delivered
DC Power Supply | 1 | 1 | $48.48 | $48.48 | Received/Delivered | 2026-07-03 | 2026-07-04 | Amazon | B0DDPVDWPZ | JESVERTY |  | DC Power Supply Variable, 0-32V 0-10A | https://www.amazon.com/dp/B0DDPVDWPZ?smid=A1ESSXTD1TYBDH&ref_=chk_typ_imgToDp&th=1 |  | DC Power Supply Variable, 0-32V 0-10A Switching Bench Power Supply with 20W USB & Type-C Quick-Charge, Encoder Corase & Fine Adjustment Knob, Output Switch, 4-Digit LED Display - SPS-3010V | Partially Ordered
HDMI Cables, 6ft | 1 | 3 | $4.58 | $13.73 | Received/Delivered | 2026-07-06 |  | Amazon | B01H7M6YKI |  |  | 3-Pack, 6 ft, High-Speed 4K@60Hz HDMI 2.0 Cord, 18Gbps, 2160p, 48 bit | https://www.amazon.com/dp/B01H7M6YKI?ref=ppx_yo2ov_dt_b_fed_asin_title&th=1 |  | Amazon Basics HDMI Cable, 3-Pack, 6 ft, High-Speed 4K@60Hz HDMI 2.0 Cord, 18Gbps, 2160p, 48 bit, Compatible with TV/PS5/Xbox/Roku/Blu-ray, Ethernet Ready, Black | In Shipping
USB & USBC Flashdrive, 128 GB | 1 | 1 | $14.41 | $14.41 | Received/Delivered | 2026-07-06 |  | Amazon | B088LMS5VV |  |  | Flash Drive 128GB 2 in 1 OTG USB 3.0/Type C | Amazon.com: KOOTION USB C Flash Drive 128GB 2 in 1 OTG USB 3.0/Type C Thumb Drive Dual Drive USB C Memory Stick for Smartphone/Laptop/Tablet/PC - 128G, Blue : Electronics |  | KOOTION USB C Flash Drive 128GB 2 in 1 OTG USB 3.0/Type C Thumb Drive Dual Drive USB C Memory Stick for Smartphone/Laptop/Tablet/PC - 128G, Blue | Blocked by Testing
Display Port to HDMI Adapter | 1 | 1 | $7.99 | $7.99 | Received/Delivered | 2026-07-06 |  | Amazon | B0CYHB956B |  |  | Display Port to HDMI 4K Adapter | Amazon.com: UANTIN Display Port to HDMI 4K Adapter | Braided DP DisplayPort Male to HDMI Female Uni-Directional Converter for PC Dell HP AMD NVIDIA Laptop HDTV Monitor and Other Passive : Electronics |  | Display Port to HDMI 4K Adapter | Braided DP DisplayPort Male to HDMI Female Uni-Directional Converter for PC Dell HP AMD NVIDIA Laptop HDTV Monitor and Other Passive | To be Ordered
USB female to USB C male adapter | 1 | 4 | $1.75 | $6.99 | Received/Delivered | 2026-07-06 |  | Amazon | B0DY5RJGCR |  |  | USB C to USB Adapter 4 Pack | Amazon.com: AVMAX USB C to USB Adapter 4 Pack,USBC Male to USB 3.0 Female OTG Adapter,Type C Male to A Female 3.0 OTG Adapter for Apple iPhone 16 15,Flash Thumb Drive,Mac,iPad,Samsung Galaxy : Electronics |  | AVMAX USB C to USB Adapter 4 Pack,USBC Male to USB 3.0 Female OTG Adapter,Type C Male to A Female 3.0 OTG Adapter for Apple iPhone 16 15,Flash Thumb Drive,Mac,iPad,Samsung Galaxy | Order Pending
NUCLEO-G474RE | 1 | 2 | $24.48 | $48.97 | Received/Delivered | 2026-07-25 |  | STMelectronics |  |  |  |  |  | UPS GROUND: 1Z7759450324444260 |  | Need Replacement
TP-Link Deco AXE5400 Tri-Band WiFi 6E Mesh System(Deco XE75) | 1 | 1 | $294.96 | $294.96 | Received/Delivered | 2026-07-28 | 2026-07-28 | Best Buy | SKU: 6508223 |  |  | Tri-band | https://www.bestbuy.com/product/tp-link-deco-xe75-pro-axe5400-tri-band-wi-fi-6e-whole-home-mesh-system-3-pack-white/J39QK2QCVK/sku/6508223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 |  | TP-Link - Deco XE75 Pro AXE5400 Tri-Band Wi-Fi 6E Whole Home Mesh System (3-Pack) - White | To be Manufactured
Planetary Gear Motor | 4 | 4 | $61.30 | $245.20 | Order Pending | 2026-07-29 |  | goBILDA | SKU: 5203-2402-0027 |  |  |  | https://www.gobilda.com/5203-series-yellow-jacket-planetary-gear-motor-26-9-1-ratio-24mm-length-8mm-rex-shaft-223-rpm-3-3-5v-encoder/ | Order Num: 200129494 | 5203 Series Yellow Jacket Planetary Gear Motor (26.9:1 Ratio, 24mm Length 8mm REX® Shaft, 223 RPM, 3.3 - 5V Encoder) | N/A
Encoder Cables: 4-Pos JST XH [MH-FC] to 4 x 1-Pos TJC8 [MH-FC] | 4 | 4 | $4.45 | $17.79 | Order Pending | 2026-07-29 |  | goBILDA | SKU: 3801-0919-0300 |  |  |  | https://www.gobilda.com/encoder-breakout-cable-4-pos-jst-xh-mh-fc-to-4-x-1-pos-tjc8-mh-fc-300mm-length/ | Order Num: 200129494 | Encoder Breakout Cable (4-Pos JST XH [MH-FC] to 4 x 1-Pos TJC8 [MH-FC], 300mm Length)
Motor to Driver Power Cables | 4 | 4 | $2.78 | $11.10 | Order Pending | 2026-07-29 |  | goBILDA | SKU: 3800-0013-0300 |  |  |  | https://www.gobilda.com/3-5mm-bullet-lead-mh-fc-300mm-length/ | Order Num: 200129494 | 3.5mm Bullet Lead (MH-FC, 300mm Length)
Wheel Hub (Sonic) | 4 | 4 | $8.91 | $35.63 | Order Pending | 2026-07-29 |  | goBILDA | SKU: 1309-0016-4008 |  |  |  | https://www.gobilda.com/1309-series-sonic-hub-8mm-rex-bore/ | Order Num: 200129494 | 1309 Series Sonic Hub (8mm REX® Bore)
M4 Socket 12mm (24 pack) | 1 | 1 | $4.78 | $4.78 | Order Pending | 2026-07-29 |  | goBILDA | SKU: 2822-0004-0012 |  |  |  | https://www.gobilda.com/premium-m4-socket-head-thread-locking-screw-12mm-length-25-pack/ | Order Num: 200129494 | Premium M4 Socket Head Thread-Locking Screw (12mm Length) - 25 Pack
Traction Wheel | 4 | 4 | $11.14 | $44.55 | Order Pending | 2026-07-29 |  | goBILDA | SKU: 3626-0014-0096 |  |  |  | https://www.gobilda.com/hogback-traction-wheel-96mm-diameter-50a-durometer/ | Order Num: 200129494 | Hogback Traction Wheel (96mm Diameter, 50A Durometer)
Motor Driver Carrier | 4 | 4 | $21.50 | $85.98 | Received/Delivered | 2026-07-29 |  | Pololu | Item Number: 1451 |  |  |  | https://www.pololu.com/product/1451 | Salesorder 1J592793 | VNH5019 Motor Driver Carrier: operates from 5.5 to 24 V and can deliver a continuous 12 A (30 A peak). It works with 2.5 to 5 V logic levels, supports ultrasonic (up to 20 kHz) PWM, and features current sense feedback (an analog voltage proportional to the motor current). Along with built-in protection against reverse-voltage, over-voltage, under-voltage, over-temperature, and over-current
 |  |  |  |  | N/A
 |  |  |  |  | N/A
 |  |  |  |  | N/A |  |  |  |  |  |  |  |  |  |  | Total Budget: | $2000.00
 |  |  |  |  | N/A |  |  |  |  |  |  |  |  |  |  | Total Spent: | $1173.85
Switch |  |  |  |  | N/A |  |  |  |  |  |  |  |  |  |  | Remainder | $826.15
Relays |  |  |  |  | N/A
Fuses |  |  |  |  | N/A
3D Printer |  |  |  |  | N/A
Voltage Regulators |  |  |  |  | N/A
Buck Converters |  |  |  |  | N/A
E-Stop Button |  |  |  |  | N/A
 |  |  |  |  | N/A
 |  |  |  |  | N/A
Oscilloscope |  |  |  |  | N/A
Solder Fan |  |  |  |  | N/A
 |  |  |  |  | N/A
