AntonioVentimiglia/Buddy_Robot/CAD/M4 Socket Head Thread-Locking Screw (12mm Length).step

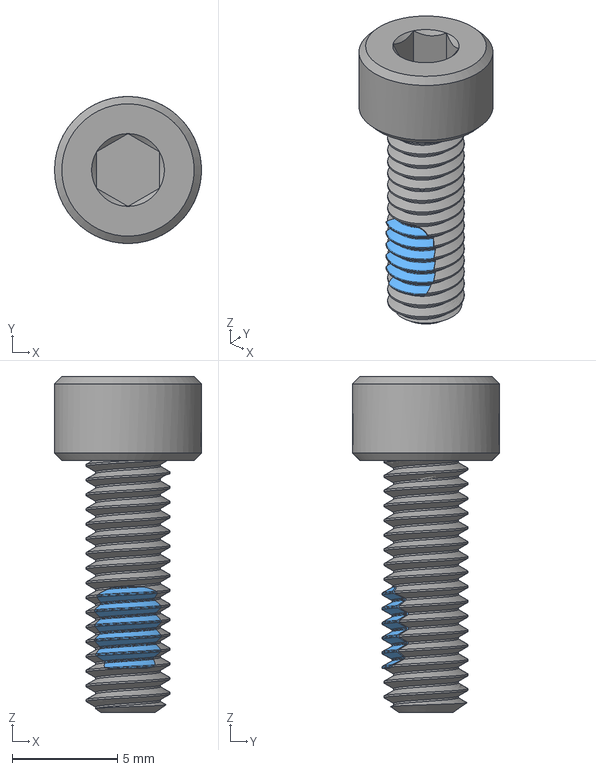
[picture p1: CAD file, 2026-07-30]
CAD/M4 Socket Head Thread-Locking Screw (12mm Length).step
7.00 x 7.00 x 16.0 mm
