AntonioVentimiglia/Buddy_Robot/CAD/Sonic Hub/Sonic Hub.SLDASM

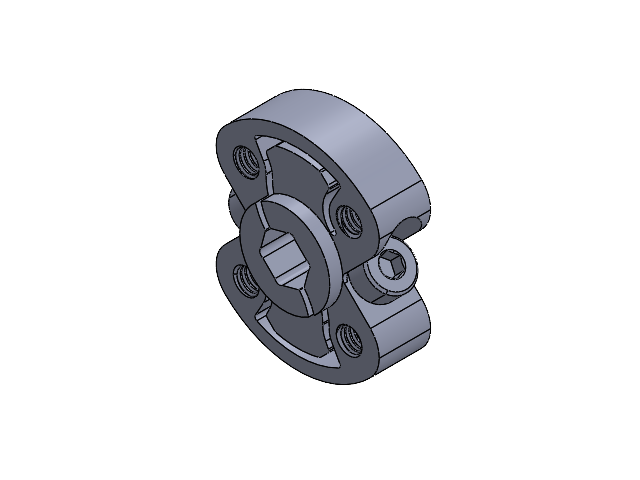
[picture p2: CAD file, 2026-07-30]
CAD/Sonic Hub/Sonic Hub.SLDASM
1309-0016-4008.STEP
2800-0004-0014_90128A207.STEP x 2
