AntonioVentimiglia/Buddy_Robot/electronics/KiCAD/drive_mcu_wiring/drive_mcu_wiring.pdf

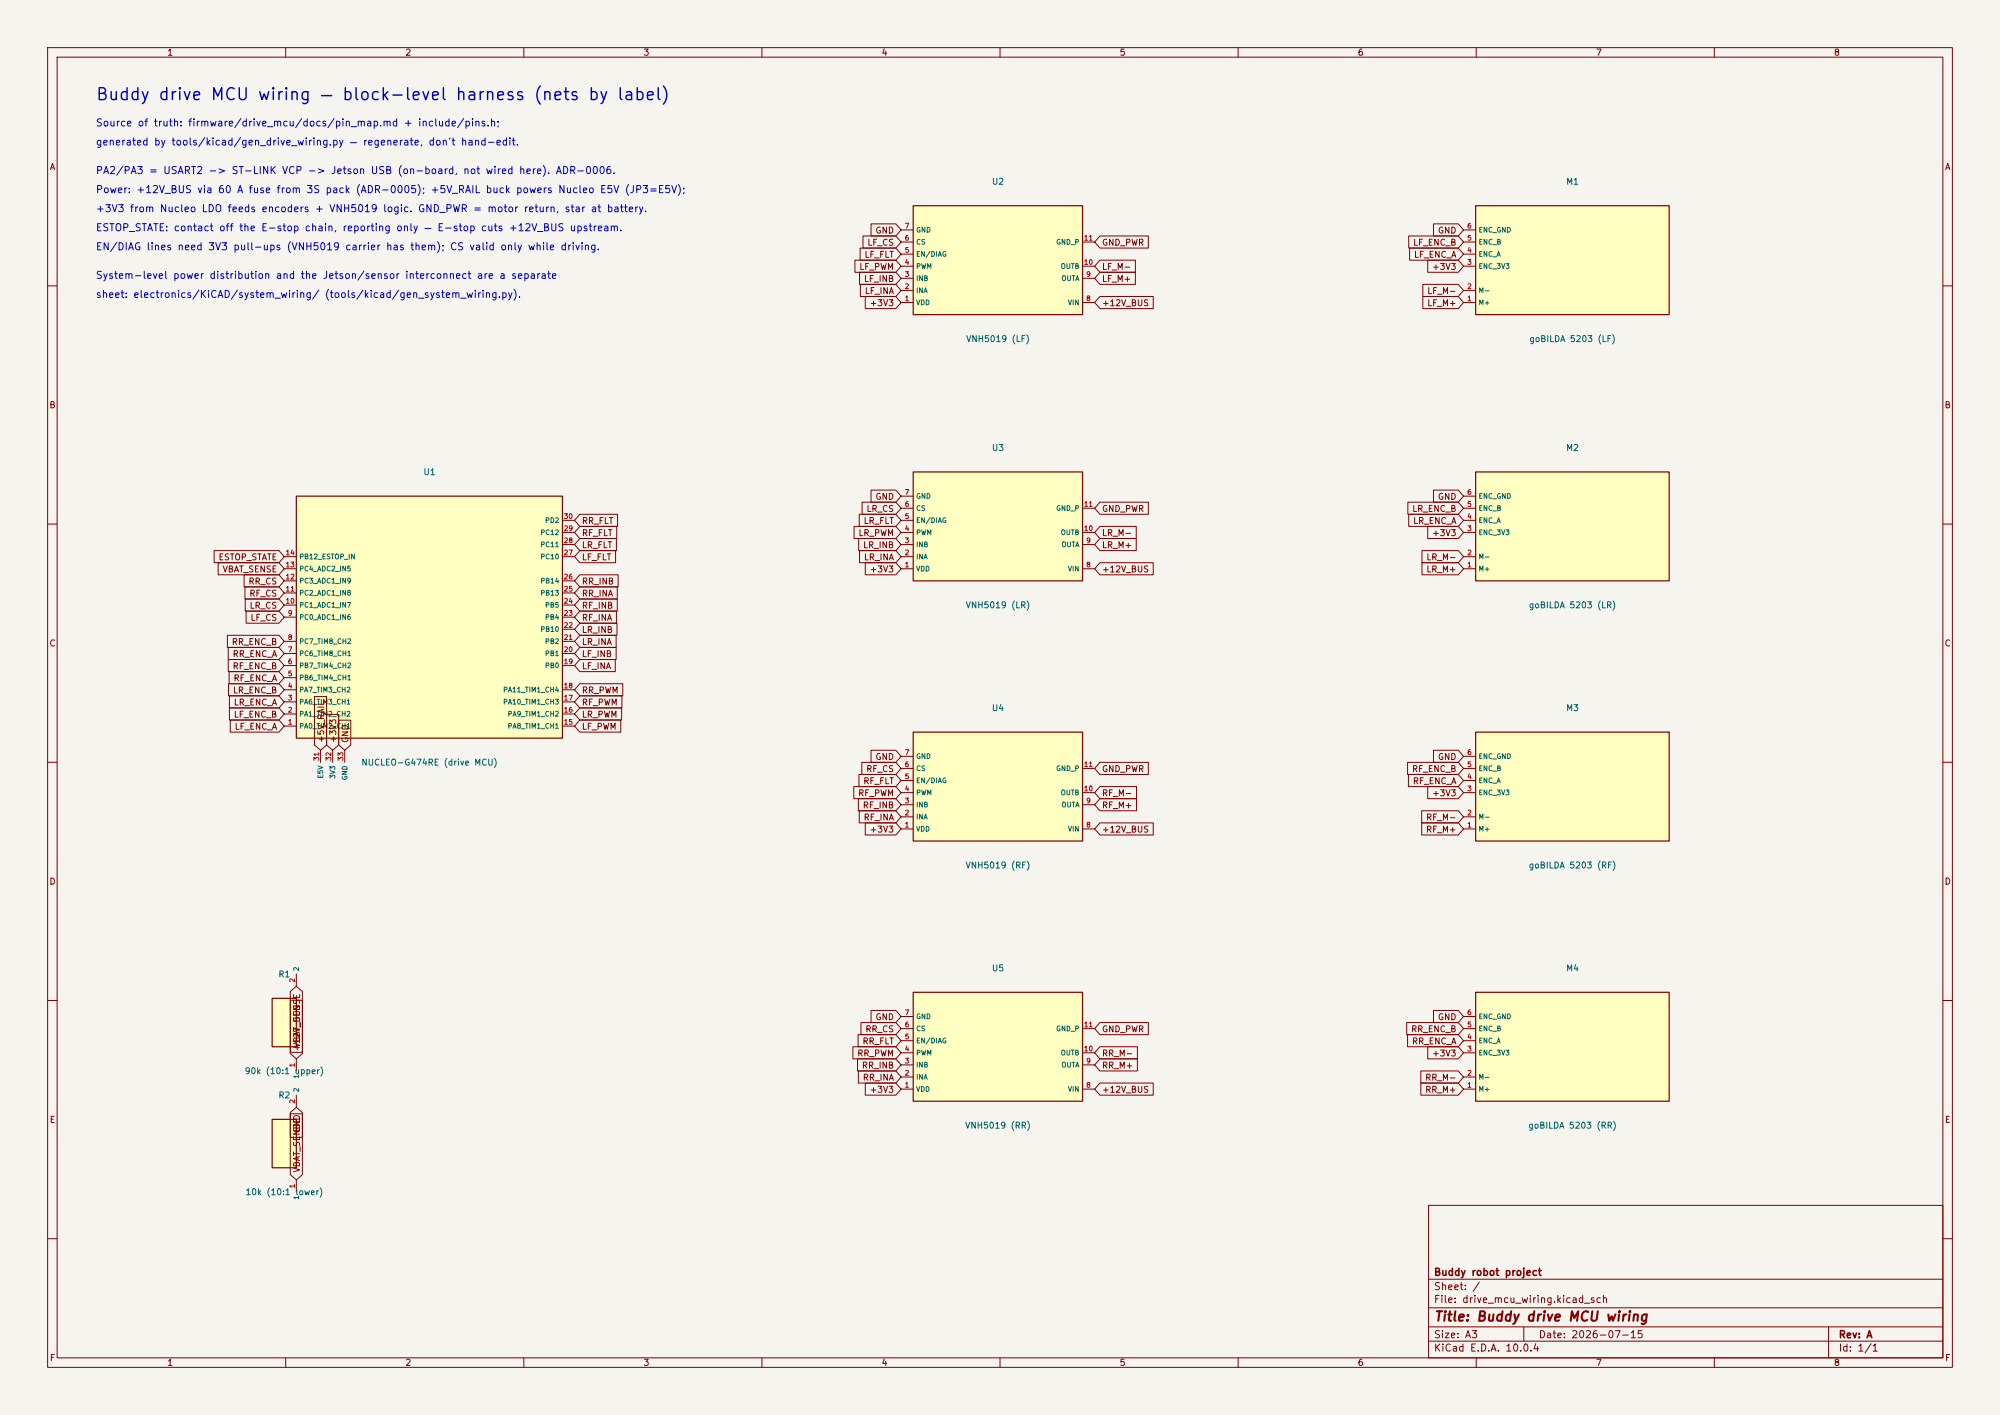
[picture p4: page 1]

Buddy drive MCU wiring — block-level harness (nets by label)

Source of truth: firmware/drive_mcu/docs/pin_map.md + include/pins.h;
generated by tools/kicad/gen_drive_wiring.py — regenerate, don't hand-edit.

PA2/PA3 = USART2 -> ST-LINK VCP -> Jetson USB (on-board, not wired here). ADR-0006.
Power: +12V_BUS via 60 A fuse from 3S pack (ADR-0005); +5V_RAIL buck powers Nucleo E5V (JP3=E5V);
+3V3 from Nucleo LDO feeds encoders + VNH5019 logic. GND_PWR = motor return, star at battery.
ESTOP_STATE: contact off the E-stop chain, reporting only — E-stop cuts +12V_BUS upstream.
EN/DIAG lines need 3V3 pull-ups (VNH5019 carrier has them); CS valid only while driving.

System-level power distribution and the Jetson/sensor interconnect are a separate
sheet: electronics/KiCAD/system_wiring/ (tools/kicad/gen_system_wiring.py).

Sheet: /
File: drive_mcu_wiring.kicad_sch
Title: Buddy drive MCU wiring

Size: A3 | Rev: A
KiCad E.D.A. 10.0.4 | Id: 1/1
