AntonioVentimiglia/Buddy_Robot/electronics/KiCAD/drive_mcu_wiring/drive_mcu_wiring.kicad_sch

## KiCad design electronics/KiCAD/drive_mcu_wiring/drive_mcu_wiring.kicad_sch (2026-07-29, an earlier design)

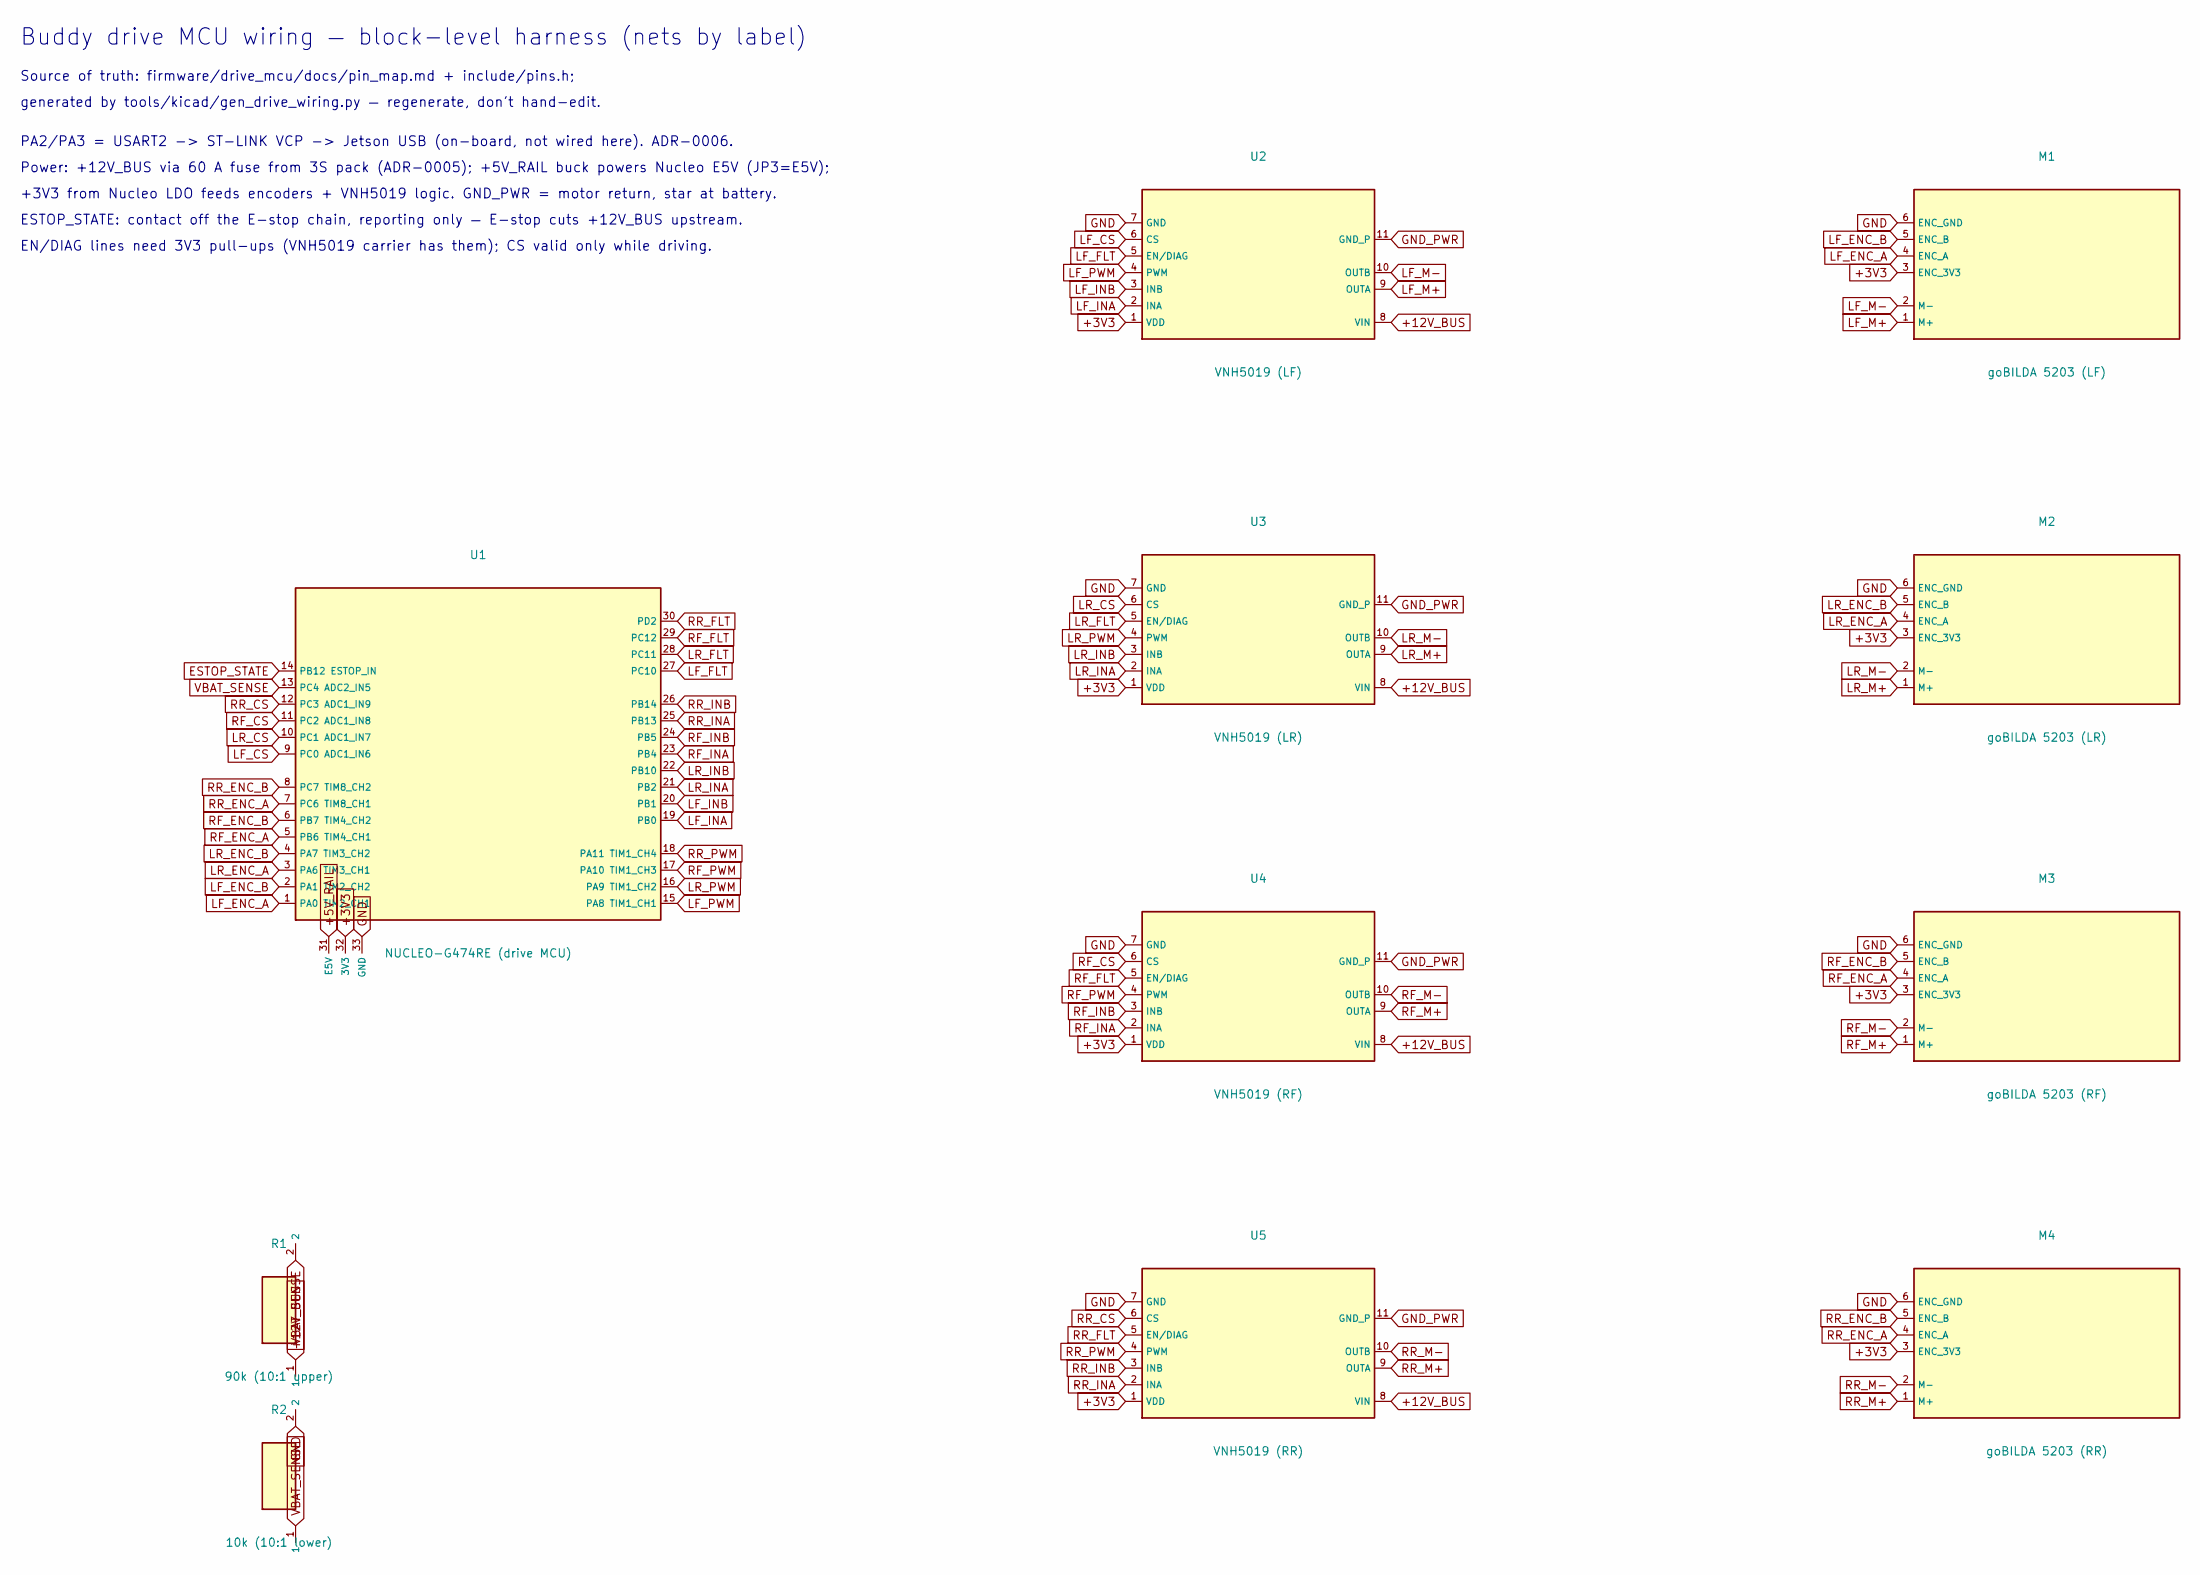
[picture p5: schematic drive_mcu_wiring.kicad_sch]

Parts:
M1: goBILDA 5203 (LF)
M2: goBILDA 5203 (LR)
M3: goBILDA 5203 (RF)
M4: goBILDA 5203 (RR)
R1: 90k (10:1 upper)
R2: 10k (10:1 lower)
U1: NUCLEO-G474RE (drive MCU)
U2: VNH5019 (LF)
U3: VNH5019 (LR)
U4: VNH5019 (RF)
U5: VNH5019 (RR)

Connections:
+3V3: M1.3 (ENC_3V3), M2.3 (ENC_3V3), M3.3 (ENC_3V3), M4.3 (ENC_3V3), U1.32 (3V3), U2.1 (VDD), U3.1 (VDD), U4.1 (VDD), U5.1 (VDD)
+5V_RAIL: U1.31 (E5V)
+12V_BUS: R1.1, U2.8 (VIN), U3.8 (VIN), U4.8 (VIN), U5.8 (VIN)
ESTOP_STATE: U1.14 (PB12 ESTOP_IN)
GND: M1.6 (ENC_GND), M2.6 (ENC_GND), M3.6 (ENC_GND), M4.6 (ENC_GND), R2.2, U1.33 (GND), U2.7 (GND), U3.7 (GND), U4.7 (GND), U5.7 (GND)
GND_PWR: U2.11 (GND_P), U3.11 (GND_P), U4.11 (GND_P), U5.11 (GND_P)
LF_CS: U1.9 (PC0 ADC1_IN6), U2.6 (CS)
LF_ENC_A: M1.4 (ENC_A), U1.1 (PA0 TIM2_CH1)
LF_ENC_B: M1.5 (ENC_B), U1.2 (PA1 TIM2_CH2)
LF_FLT: U1.27 (PC10), U2.5 (EN/DIAG)
LF_INA: U1.19 (PB0), U2.2 (INA)
LF_INB: U1.20 (PB1), U2.3 (INB)
LF_M+: M1.1 (M+), U2.9 (OUTA)
LF_M-: M1.2 (M-), U2.10 (OUTB)
LF_PWM: U1.15 (PA8 TIM1_CH1), U2.4 (PWM)
LR_CS: U1.10 (PC1 ADC1_IN7), U3.6 (CS)
LR_ENC_A: M2.4 (ENC_A), U1.3 (PA6 TIM3_CH1)
LR_ENC_B: M2.5 (ENC_B), U1.4 (PA7 TIM3_CH2)
LR_FLT: U1.28 (PC11), U3.5 (EN/DIAG)
LR_INA: U1.21 (PB2), U3.2 (INA)
LR_INB: U1.22 (PB10), U3.3 (INB)
LR_M+: M2.1 (M+), U3.9 (OUTA)
LR_M-: M2.2 (M-), U3.10 (OUTB)
LR_PWM: U1.16 (PA9 TIM1_CH2), U3.4 (PWM)
RF_CS: U1.11 (PC2 ADC1_IN8), U4.6 (CS)
RF_ENC_A: M3.4 (ENC_A), U1.5 (PB6 TIM4_CH1)
RF_ENC_B: M3.5 (ENC_B), U1.6 (PB7 TIM4_CH2)
RF_FLT: U1.29 (PC12), U4.5 (EN/DIAG)
RF_INA: U1.23 (PB4), U4.2 (INA)
RF_INB: U1.24 (PB5), U4.3 (INB)
RF_M+: M3.1 (M+), U4.9 (OUTA)
RF_M-: M3.2 (M-), U4.10 (OUTB)
RF_PWM: U1.17 (PA10 TIM1_CH3), U4.4 (PWM)
RR_CS: U1.12 (PC3 ADC1_IN9), U5.6 (CS)
RR_ENC_A: M4.4 (ENC_A), U1.7 (PC6 TIM8_CH1)
RR_ENC_B: M4.5 (ENC_B), U1.8 (PC7 TIM8_CH2)
RR_FLT: U1.30 (PD2), U5.5 (EN/DIAG)
RR_INA: U1.25 (PB13), U5.2 (INA)
RR_INB: U1.26 (PB14), U5.3 (INB)
RR_M+: M4.1 (M+), U5.9 (OUTA)
RR_M-: M4.2 (M-), U5.10 (OUTB)
RR_PWM: U1.18 (PA11 TIM1_CH4), U5.4 (PWM)
VBAT_SENSE: R1.2, R2.1, U1.13 (PC4 ADC2_IN5)

Notes on the sheet:
Buddy drive MCU wiring — block-level harness (nets by label)
Source of truth: firmware/drive_mcu/docs/pin_map.md + include/pins.h;
generated by tools/kicad/gen_drive_wiring.py — regenerate, don't hand-edit.
PA2/PA3 = USART2 -> ST-LINK VCP -> Jetson USB (on-board, not wired here). ADR-0006.
Power: +12V_BUS via 60 A fuse from 3S pack (ADR-0005); +5V_RAIL buck powers Nucleo E5V (JP3=E5V);
+3V3 from Nucleo LDO feeds encoders + VNH5019 logic. GND_PWR = motor return, star at battery.
ESTOP_STATE: contact off the E-stop chain, reporting only — E-stop cuts +12V_BUS upstream.
EN/DIAG lines need 3V3 pull-ups (VNH5019 carrier has them); CS valid only while driving.
