AntonioVentimiglia/Buddy_Robot/electronics/KiCAD/system_wiring/system_wiring.kicad_sch

## KiCad design electronics/KiCAD/system_wiring/system_wiring.kicad_sch (2026-08-01, an earlier design)

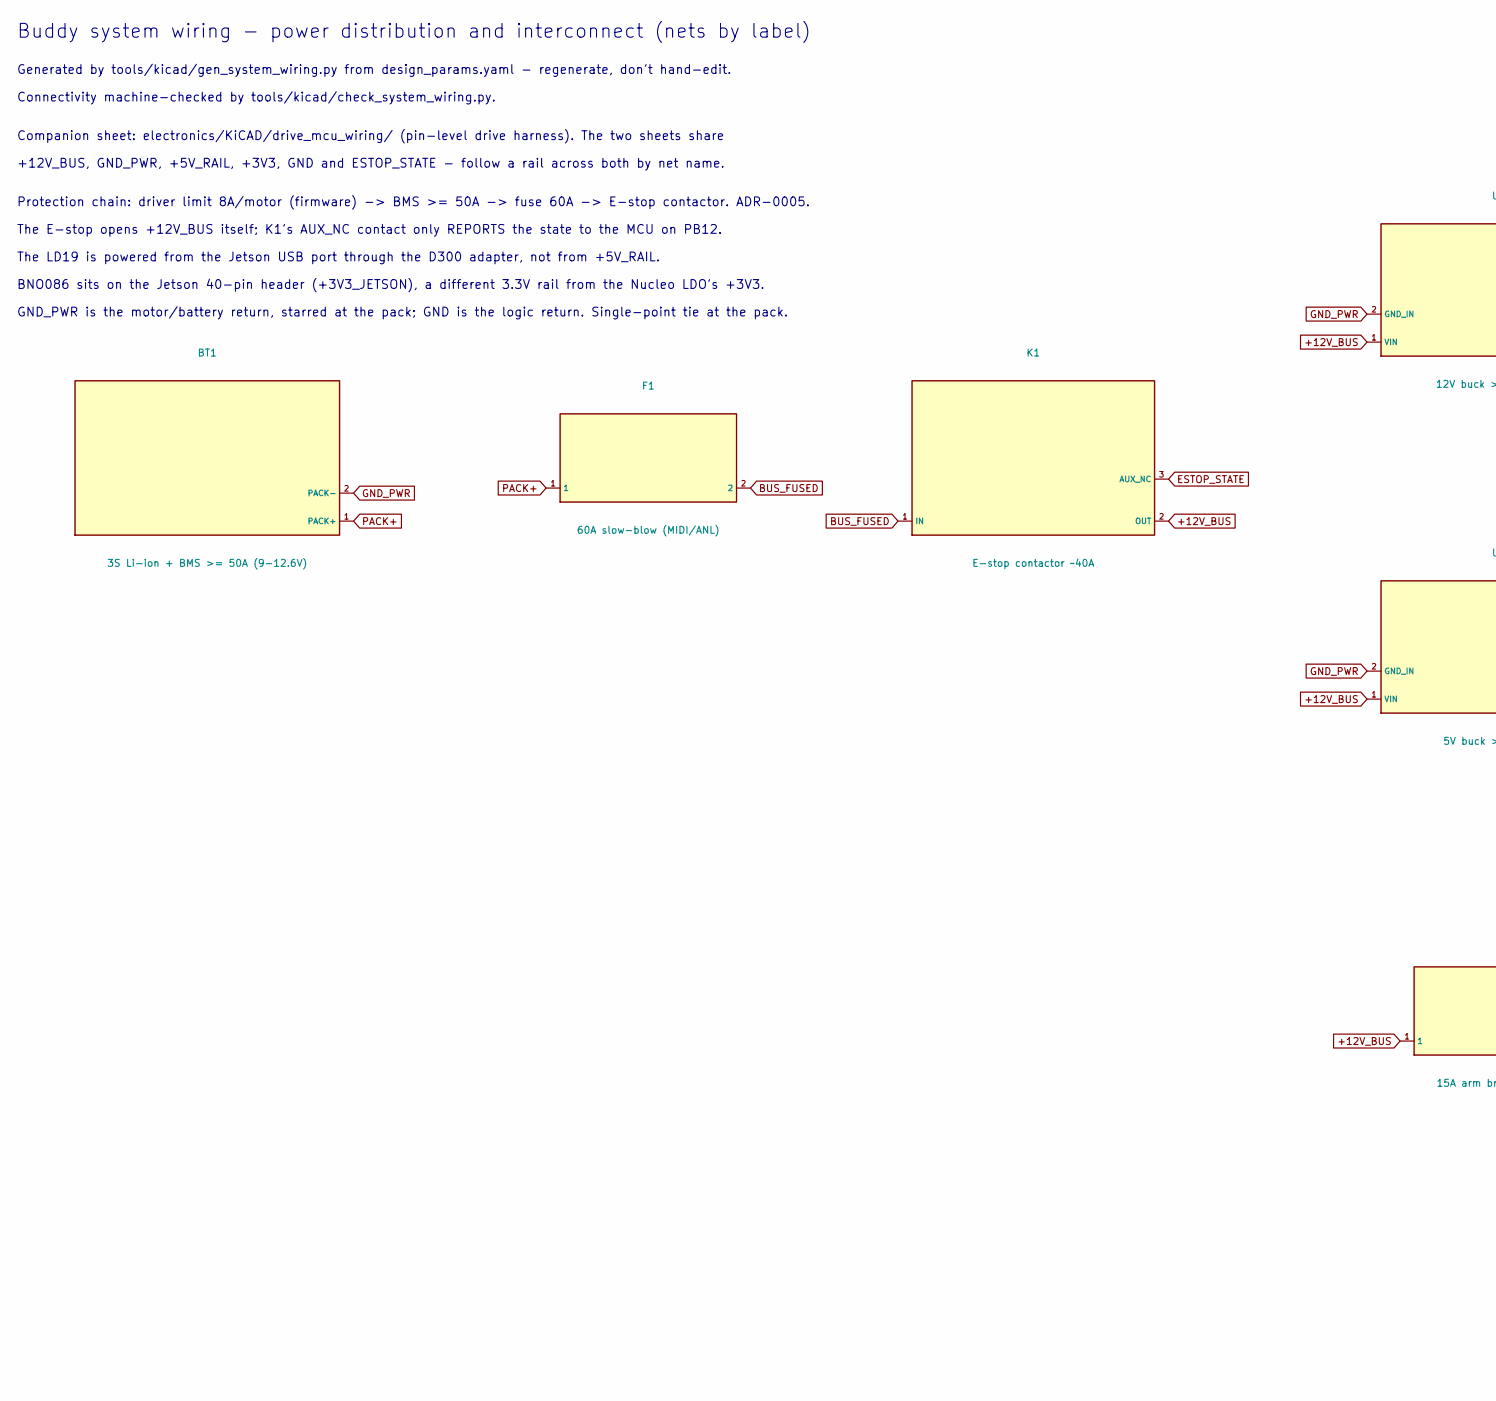
[picture p6: schematic system_wiring.kicad_sch, part in row 1, column 1]

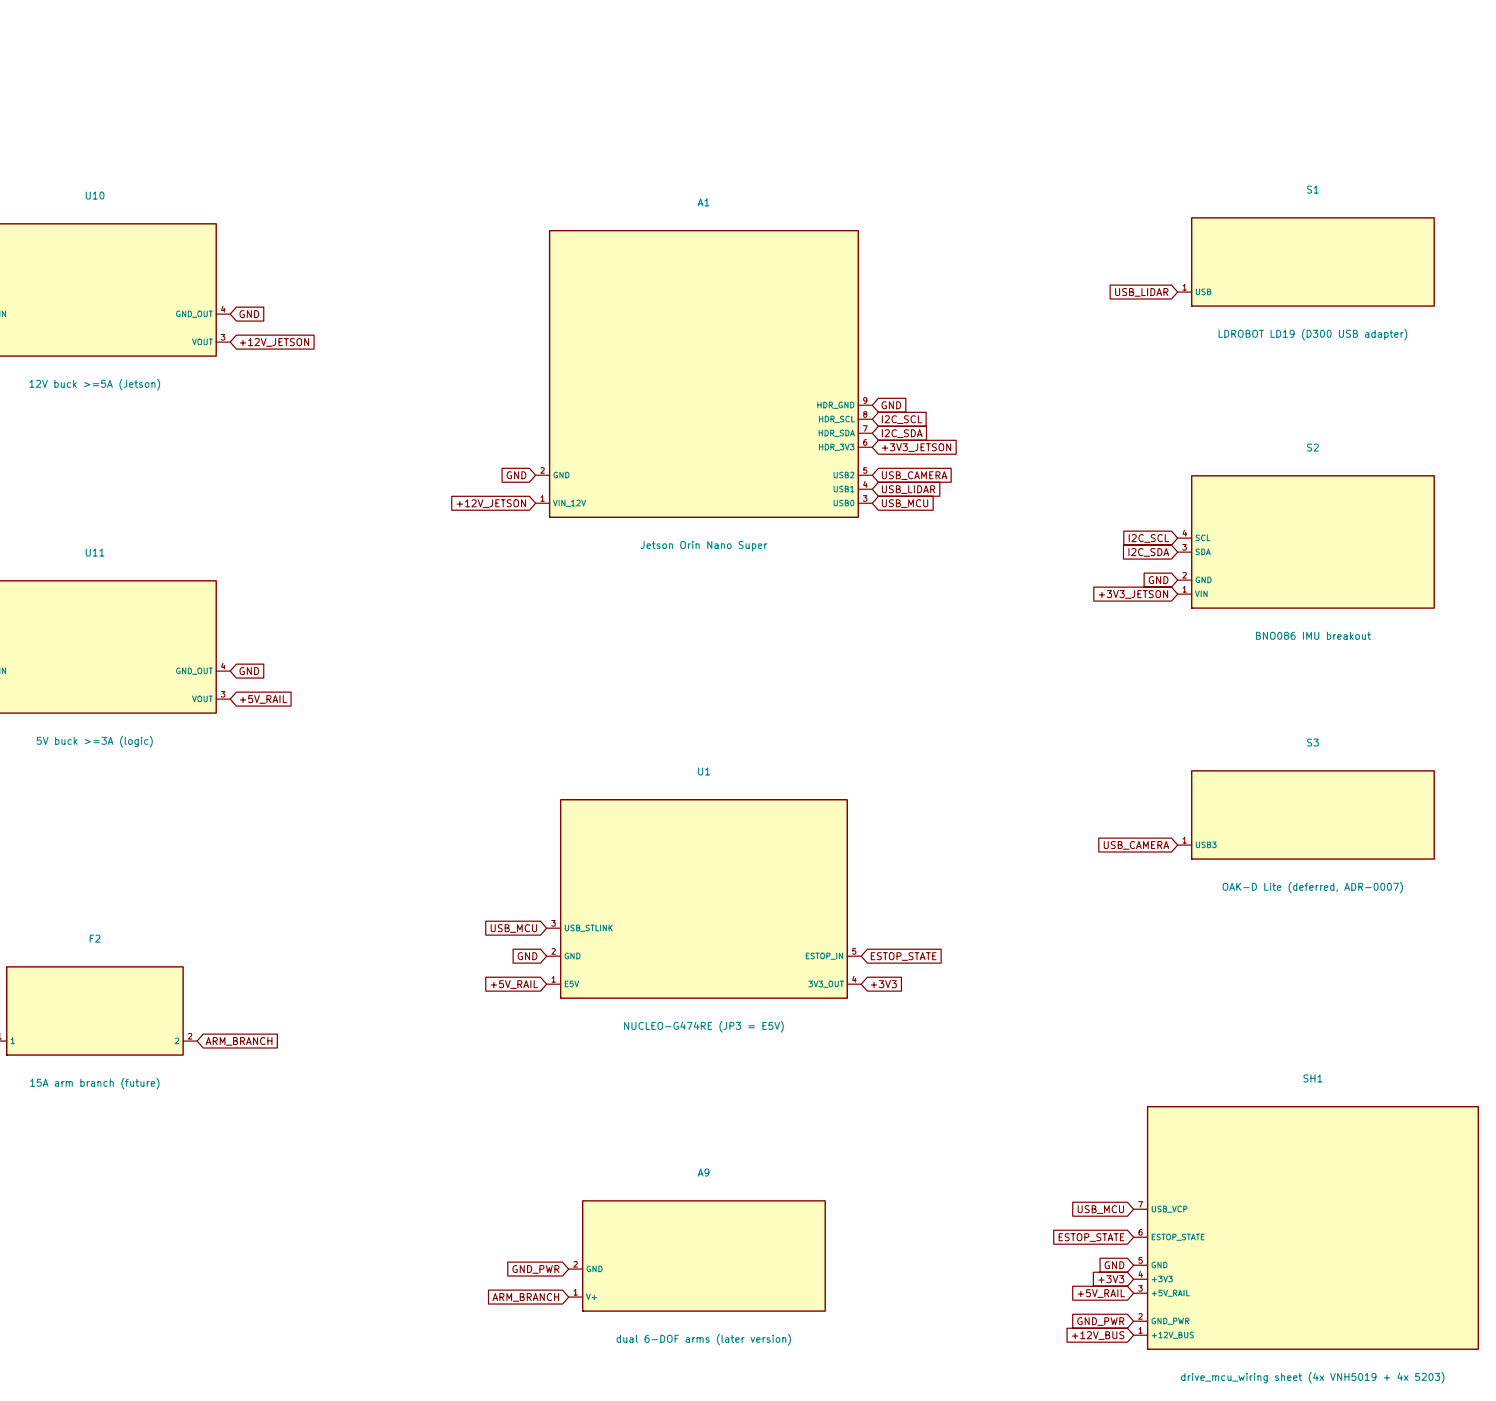
[picture p7: schematic system_wiring.kicad_sch, part in row 1, column 2]

Parts:
A1: Jetson Orin Nano Super
A9: dual 6-DOF arms (later version)
BT1: 3S Li-ion + BMS >= 50A (9-12.6V)
F1: 60A slow-blow (MIDI/ANL)
F2: 15A arm branch (future)
K1: E-stop contactor ~40A
S1: LDROBOT LD19 (D300 USB adapter)
S2: BNO086 IMU breakout
S3: OAK-D Lite (deferred, ADR-0007)
SH1: drive_mcu_wiring sheet (4x VNH5019 + 4x 5203)
U1: NUCLEO-G474RE (JP3 = E5V)
U10: 12V buck >=5A (Jetson)
U11: 5V buck >=3A (logic)

Connections:
+3V3: SH1.4 (+3V3), U1.4 (3V3_OUT)
+3V3_JETSON: A1.6 (HDR_3V3), S2.1 (VIN)
+5V_RAIL: SH1.3 (+5V_RAIL), U1.1 (E5V), U11.3 (VOUT)
+12V_BUS: F2.1, K1.2 (OUT), SH1.1 (+12V_BUS), U10.1 (VIN), U11.1 (VIN)
+12V_JETSON: A1.1 (VIN_12V), U10.3 (VOUT)
ARM_BRANCH: A9.1 (V+), F2.2
BUS_FUSED: F1.2, K1.1 (IN)
ESTOP_STATE: K1.3 (AUX_NC), SH1.6 (ESTOP_STATE), U1.5 (ESTOP_IN)
GND: A1.2 (GND), A1.9 (HDR_GND), S2.2 (GND), SH1.5 (GND), U1.2 (GND), U10.4 (GND_OUT), U11.4 (GND_OUT)
GND_PWR: A9.2 (GND), BT1.2 (PACK-), SH1.2 (GND_PWR), U10.2 (GND_IN), U11.2 (GND_IN)
I2C_SCL: A1.8 (HDR_SCL), S2.4 (SCL)
I2C_SDA: A1.7 (HDR_SDA), S2.3 (SDA)
PACK+: BT1.1 (PACK+), F1.1
USB_CAMERA: A1.5 (USB2), S3.1
USB_LIDAR: A1.4 (USB1), S1.1
USB_MCU: A1.3 (USB0), SH1.7 (USB_VCP), U1.3 (USB_STLINK)

Notes on the sheet:
Buddy system wiring - power distribution and interconnect (nets by label)
Generated by tools/kicad/gen_system_wiring.py from design_params.yaml - regenerate, don't hand-edit.
Connectivity machine-checked by tools/kicad/check_system_wiring.py.
Companion sheet: electronics/KiCAD/drive_mcu_wiring/ (pin-level drive harness). The two sheets share
+12V_BUS, GND_PWR, +5V_RAIL, +3V3, GND and ESTOP_STATE - follow a rail across both by net name.
Protection chain: driver limit 8A/motor (firmware) -> BMS >= 50A -> fuse 60A -> E-stop contactor. ADR-0005.
The E-stop opens +12V_BUS itself; K1's AUX_NC contact only REPORTS the state to the MCU on PB12.
The LD19 is powered from the Jetson USB port through the D300 adapter, not from +5V_RAIL.
BNO086 sits on the Jetson 40-pin header (+3V3_JETSON), a different 3.3V rail from the Nucleo LDO's +3V3.
GND_PWR is the motor/battery return, starred at the pack; GND is the logic return. Single-point tie at the pack.
