AntonioVentimiglia/Buddy_Robot/robot_ws/src/buddy_description/config/joint_limits.yaml

joint_limits:
  left_front_wheel_joint:
    has_velocity_limits: true
    max_velocity: 10.0
  left_rear_wheel_joint:
    has_velocity_limits: true
    max_velocity: 10.0
  right_front_wheel_joint:
    has_velocity_limits: true
    max_velocity: 10.0
  right_rear_wheel_joint:
    has_velocity_limits: true
    max_velocity: 10.0
