AntonioVentimiglia/Buddy_Robot/(commit log)

2026-06-26 First formatting
    [arm_placeholder(_IP).urdf.xacro, base_controller(_IP).yaml, base_four_wheel_diff.urdf.xacro, buddy_robot.urdf.xacro, diff_drive_controller(_IP).yaml, empty_lab(_IP).sdf, joint_limits(_IP).yaml, robot_identity.yaml]
2026-06-27 house keeping
    [buddy_robot_v0_1.urdf.xacro]
2026-06-27 simulation setup
    [buddy.urdf.xacro, empty_lab.sdf, model.sdf, torque_sweep.csv]
2026-06-28 rearrange from C
    [arm_placeholder.urdf.xacro, base_four_wheel_diff.urdf.xacro, buddy.gazebo.xacro, buddy.urdf.xacro, buddy_params.xacro, buddy_robot_v0_1.urdf.xacro, empty_lab(_IP).sdf, model.sdf]
2026-06-29 moved research folder
    [Initial_Block_Diagram.kicad_pcb, Initial_Block_Diagram.kicad_sch]
2026-06-29 Created BOM
    [Buddy_BOM.xlsx]
2026-06-29 signoff 6-29-26
    [Buddy_BOM.xlsx]
2026-07-01 6/30 signoff
    [Buddy_BOM.xlsx]
2026-07-02 bom recovery
    [Buddy_BOM.xlsx]
2026-07-02 small bom update
    [Buddy_BOM.xlsx]
2026-07-03 BOM: bought power supply
    [Buddy_BOM.xlsx]
2026-07-07 BOM: bought adapters, HDMI cables, thumb drive
    [Buddy_BOM.xlsx]
2026-07-12 Declutter repo, drop (_IP) naming, size and select drive motors
    Three related pieces of groundwork so hardware sourcing can proceed:
    Declutter (227 -> 106 tracked files)
    - Delete ~19 research folders that held only identical "TBD" templates;
    keep the two with real content (STM32 selection, roadmap PDF).
    - Delete 7 empty ROS packages (navigation, perception, manipulation,
    mission, diagnostics, operator, tests) that were pure stubs; recreate
    with `ros2 pkg create` when each build phase is reached.
    - Merge duplicate requirements files into buddy_v0_1_requirements.yaml;
    remove stale CHANGELOG, first-30-days/AI-workflow TODOs, premature
    firmware/devops stubs, KiCAD lock files, and .DS_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
    [base_controller.yaml, diff_drive_controller.yaml, joint_limits.yaml, torque_sweep.csv]
2026-07-12 Add portfolio tracking system: engineering log, milestones, figures-as-code
    Groundwork for a website generated from the repo and for defending the
    engineering in interviews (repo stays private; site renders docs/portfolio/).
    - docs/portfolio/README.md: the convention — session-level engineering log
    (log/YYYY-MM.md), one illustrated milestone report per phase, YAML
    frontmatter contract for site generation, same-day evidence capture in
    assets/evidence/, assumptions+sensitivity required on every calc.
    - docs/portfolio/log/2026-07.md: July log backfilled from git history
    (marked as reconstructions) plus today's full entry.
    - docs/portfolio/milestones/M01-drive-motor-selection.md: firs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
2026-07-12 Add derivation convention: calculations as checkable first-principles docs
    System-wide rule (portfolio README rule 3, PROJECT_CONTEXT conventions):
    every calculation is presented as a derivation an engineer can verify by
    hand — governing equations from first principles, symbol table with units,
    numeric substitution written out, units check, and limits of validity.
    Derivations live in docs/analysis/, one doc per domain; research docs and
    milestone reports cite them rather than restating math.
    - docs/analysis/drive_torque_and_pivot_scrub.md: first instance. Full
    treatment of the straight-line tractive force, torque conversion (with
    SF-on-demand rationale), wheel speed, braking, and the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
2026-07-12 Select wheels: 96mm goBILDA Hogback (ADR-0004), amend clearance requirement
    The 0.06 m wheel radius used in motor sizing was an unsourced URDF
    placeholder. goBILDA traction wheels top out at 96 mm; the Hogback's
    crowned tread is purpose-designed to reduce skid-steer pivot scrub —
    Buddy's dominant torque load case.
    Decision: 4x Hogback 96 mm (50A, $9.99 ea) + 4x 8 mm REX-bore hubs,
    ~$76 all-in. Trade: ground-clearance requirement amended 0.05 -> 0.038 m
    (the 0.05 was a round-number guess; indoor thresholds are 5-20 mm).
    At r = 0.048 m the envelope relaxes everywhere it was tight:
    design case 1.47 -> 1.18 N·m @ 149 RPM; pivot band 2.9-3.8 -> 2.29-3.06,
    giving the selected motor 22% stall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
    [buddy_params.xacro, torque_sweep.csv]
2026-07-12 Add parametric build: one yaml drives derivations, figures, URDF, and CSV
    Design values previously lived in five hand-synced places (requirements
    yaml, buddy_params.xacro, torque_sweep CLI defaults, figure-script
    constants, and markdown prose). The wheel change proved the failure mode:
    every substitution had to be chased by hand, and a rounding error
    (3.06 vs computed 3.05 N·m) had already crept into three docs.
    Single source of truth, split by responsibility:
    - design_params.yaml — chosen/assumed values (geometry, motor/wheel
    specs, crr/mu/eta/SF); requirements yaml keeps requirements; no overlap.
    - buddy_calcs/ — loader + drive equations; every consumer imports it
    (figure scripts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
    [buddy_params.xacro]
2026-07-12 Add power budget: stall current becomes a designed ceiling (ADR-0005)
    The fear: 4x 9.2 A motor stall + Jetson + sensors = impossible battery.
    The analysis shows otherwise: stall is a fault condition, and the motor
    drivers' current limit converts the worst case into a chosen number.
    - design_params.yaml power section: 3S Li-ion bus, 8 A/motor driver
    limit, load allocations with RESERVES for unchosen hardware (camera
    and LiDAR <= 5 W each) that become hard selection constraints.
    - buddy_calcs/power.py: motor current model I(T), torque-at-limit
    inverse, peak scenarios, mission energy model, capacity sizing, and
    validate() wired into tools/build.py. The validator caught the first
    desi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
    [build.py, design_params.yaml]
2026-07-13 Add driver shortlist (VNH5019 recommended) and v0.1 shopping list
    Driver research against ADR-0005's hard requirement (adjustable ~8A
    per-channel limit): 4x Pololu VNH5019 recommended — 12A/30A per channel,
    140mV/A current sense feeding the G474's ADCs for the firmware limit,
    hardware overcurrent backstop. RoboClaw 2x15A (premium), TB67H420FTG
    (3.4A continuous too thin vs 3.1A sustained case), BTS7960 (budget)
    documented as alternates. NUCLEO-G474RE confirmed as drive MCU; the
    dual-VNH5019 shield stacks on it for the first bench loop.
    docs/financials/SHOPPING_LIST_v0_1.md (temporary): full v0.1 cart ~$540
    of the $300-600 budget with trim options; delete after purchases land in
    the BOM and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
2026-07-13 Add portfolio website generator: site/ rendered from the repo
    tools/site/build_site.py (wired into tools/build.py) renders milestones,
    analyses, ADRs, and the engineering log into a 10-page static site:
    - Engineering-clean light design; the site inherits the figure palette
    (same surface/ink/blue tokens) so SVGs blend seamlessly into cards.
    Helvetica Neue prose + monospace utility face for spec chips/units/ids.
    Single light theme as a deliberate choice matching figures-as-code.
    - Landing page spec chips are computed from buddy_calcs at build time -
    the website is a parametric artifact like the figures and the URDF.
    - KaTeX renders the derivation math (math spans protected from the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
2026-07-14 Site: nav tab hierarchy, section index pages, identity, Pages deploy script
    - Nav: Overview / Milestones / Analyses / Decisions / Log, with an index
    page per section (cards for milestones/analyses, ADR list with status).
    - Identity from tools/site/site_config.yaml (name, role, links) rendered
    in the landing hero and every footer; LinkedIn/resume slots ready.
    - Costs stay on the site (user decision: cost-constrained design is part
    of the engineering story).
    - tools/site/deploy_github_pages.sh publishes site/ to a separate public
    repo when the user is ready; working repo stays private.
2026-07-14 Site: add static-assets folder so a resume PDF survives rebuilds
    tools/site/static/ is copied verbatim into site/ on every build (site/
    itself is fully wiped and regenerated, so a file dropped straight into
    site/ would vanish on the next build — this is the actual source
    location). site_config.yaml's Resume link now points at resume.pdf,
    wired at every page depth; the file itself isn't committed since it
    doesn't exist yet.
2026-07-14 Re-size battery for future dual 6-DOF arms (ADR-0005 amendment)
    Two 6-DOF arms are planned for a later version on the same battery; an
    8 Ah v0.1 pack would be wasted when they arrive. Provisioned as an
    explicit placeholder (12 XM430-class joints: +45 W avg, +10 A peak) in
    design_params.yaml -> power.future_arms, to be replaced with real servo
    specs at arm selection.
    Cascade: designed peak 37 -> 47 A incl. arm branch; BMS >= 50 A; main
    fuse 60 A slow-blow on 8 AWG bus; arm branch fused at 15 A; battery
    target >= 14 Ah (~155 Wh, $100-140, still mild 3.4C). v0.1 runtime at
    expected load grows to ~90 min on the same pack. Mass +0.6-0.8 kg is
    absorbed by the 20 kg design ceiling already used in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
    [buddy_v0_1_requirements.yaml, design_params.yaml]
2026-07-14 Verify drive-chain electrical interfaces signal-by-signal
    Purchases proceed on the assumption that motors <-> VNH5019 <-> G474 <->
    Jetson interoperate; docs/system_model/electrical_interfaces.md now
    checks that assumption with numbers instead of hope:
    - VNH5019 logic high >= 2.1 V -> 3.3 V-native with the G474, no level
    shifters anywhere (encoders also run at 3.3 V).
    - TIM1 @ 170 MHz gives 20 kHz PWM with ~13-bit duty resolution (driver
    max is 20 kHz); TIM2/3/4/8 provide four true hardware quadrature
    decoders (11.2 kcounts/s demand vs MHz capability).
    - Current sense: 140 mV/A -> 1.12 V at the 8 A limit into a 3.3 V
    12-bit ADC (~5.8 mA/LSB), sampled mid-PWM-pulse via timer trigger.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
2026-07-14 Drive protocol v1: ADR-0006, wire spec, dual implementations, mock MCU
    Task 1+3 of the autonomous worklist, in depth:
    - ADR-0006: MCU<->Jetson bus = USB serial via the Nucleo's STLINK-V3E
    VCP for v0.1 (zero extra hardware, 18x bandwidth margin, watchdog
    latency requirements trivially met); CAN-FD reserved as the growth
    path (G474 has FDCAN on-chip); micro-ROS rejected because the MCU
    must stay safe with ROS entirely absent.
    - firmware/shared_protocol/drive_protocol.md: complete wire spec -
    framed 0xB5DD + version + type + seq + len + payload + CRC-16/CCITT-
    FALSE; CMD_VEL/CMD_MODE/PING/TELEMETRY(39B)/PONG/FAULT_EVT; state
    machine and fault-bit tables; behavioral rules incl. th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
2026-07-14 Drive MCU firmware: pin map, host-tested safety core, compiles for G474
    Task 2 of the autonomous worklist. Wiring day is now flash-and-test:
    - docs/pin_map.md + include/pins.h (change together): TIM2/3/4/8 as four
    hardware quadrature decoders, TIM1 CH1-4 PWM at 20 kHz (~13-bit duty),
    ADC1 on PC0-3 for VNH5019 current sense, fault GPIOs, E-stop chain
    input (reporting only - hardware cuts power upstream), VCP on PA2/3.
    Conflicts checked; morpho-only pins flagged.
    - src/state_machine.{c,h}: the safety core as pure C with injected time
    - 19 host tests pass, incl. watchdog stop at exactly >200 ms with
    targets zeroed, E-stop dominance over CLEAR_FAULT, no auto-run on
    E-stop release,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
2026-07-15 buddy_base bridge: host-tested drive stack, end-to-end vs mock MCU
    The last missing piece of the v0.1 drive software, written and tested
    before any hardware exists:
    - base_core.py: all drive logic as plain Python, no ROS dependency -
    skid-steer kinematics (ratio-preserving clamp), diff-drive odometry
    (midpoint integration, wrapped heading), keep-alive command pacing
    sized against the MCU's 200 ms watchdog, MCU state/fault mirroring.
    Geometry comes from design_params.yaml via buddy_calcs, not hand-kept
    yaml (deleted the stale configs carrying wrong 0.08 m/0.49 m values).
    - 8 unit tests + 5 end-to-end integration tests against the mock MCU
    through real protocol bytes: straight-lin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
    [base_controller.yaml, diff_drive_controller.yaml]
2026-07-15 Sensor suite selected, phased (ADR-0007): LD19 + BNO086 now, OAK-D Lite deferred
    2D LiDAR: LDROBOT LD19 (~$70) - ToF 12 m, 0.9 W vs the 5 W reserve,
    30 klux, active ROS 2 driver. IMU: BNO085/BNO086 breakout (~$25),
    on-chip fusion, Jetson I2C. RGB-D: OAK-D Lite (~$140) SELECTED but
    deferred - its on-camera VPU offloads the Orin Nano, and nothing in
    TODO Phases 5-7 needs a camera, so it would idle if bought now.
    RealSense D435 rejected on price (~2x); revisit only if OAK passive
    stereo disappoints for manipulation-grade depth.
    Budget honesty: Phase A adds $90 (total ~$685); full suite ~$810 -
    an explicit budget extension recorded in the ADR (conflict #4). Both
    sensors fit their power reserves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
2026-07-15 Jetson bring-up script, M02 milestone, session log
    - devops/jetson/setup_ros2_jazzy.sh (idempotent): ROS 2 Jazzy install,
    workspace build with --symlink-install, full host test suite, ending
    at the zero-hardware milestone: teleop -> bridge -> mock MCU -> /odom
    on the actual robot computer. Setup doc rewritten around it.
    - Real udev rule for the ST-LINK VCP (0483:374e -> /dev/buddy_drive_mcu);
    base.launch.py defaults to the stable name.
    - M02 milestone report: the stall-current reframe, the validator catch
    (7 A limit < pivot demand), and sizing the battery once for the
    future dual-arm version. Site rebuilt - M02 and ADR-0007 now render.
    - Log entry for the session; PROJECT_CONTEXT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
2026-07-16 KiCAD drive-MCU harness schematic: generated, rendered, machine-verified
    - tools/kicad/gen_drive_wiring.py emits a native KiCAD 10 schematic
    (electronics/KiCAD/drive_mcu_wiring/): NUCLEO-G474RE block, 4x VNH5019
    carriers, 4x goBILDA motor/encoder units, Vbat 10:1 divider, and
    power/E-stop/VCP notes. Connectivity by named nets, same tables as
    docs/pin_map.md + include/pins.h (all three say so).
    - tools/kicad/check_drive_wiring.py: exports the netlist via kicad-cli
    and asserts all 43 nets pin-by-pin - every MCU pin to its exact
    driver/encoder counterpart, rail memberships counted. ALL PASS.
    'Wire connections checked' is now a mechanical claim.
    - Iteration fixed two real generator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
    [drive_mcu_wiring.kicad_sch]
2026-07-26 Motor datasheet: fix 4x encoder scaling bug, document the harness
    Spec sheet for 5203-2402-0027 arrived and contradicted two things built
    from the vendor web page:
    1. ENCODER SCALING (serious). Datasheet: 'Encoder Shaft: 28 Pulses per
    Rotation (7 Cycles)' -> 28/7 = 4, so goBILDA 'pulses' are ALREADY
    4x-decoded counts. Code multiplied by 4 again: 3007 counts/rev
    instead of 753.2, i.e. odometry would report ~1/4 of true distance.
    Renamed the parameter encoder_ppr_output -> encoder_counts_per_rev_output
    so the unit is unambiguous at every call site; fixed design_params,
    the generated buddy_config.h, base_core.py, both test suites, and the
    mock MCU wheel model. All six host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
    [base_core.py, build.py, design_params.yaml]
2026-07-29 wifi and STM BOM update
    [Buddy_BOM.xlsx]
2026-07-29 System integration: six generated figures, a topology map, and a checker
    Integration knowledge was spread across six correct documents and one wrong
    drawing. assets/diagrams/system_architecture_mermaid.md was hand-made, not
    generated, and still showed a CAN bridge two weeks after ADR-0006 chose USB
    serial. Deleted. A drawing that isn't generated is already wrong; it just
    hasn't been caught yet.
    TOPOLOGY IS NOW DATA
    docs/system_model/integration_map.yaml owns what connects to what -- ROS
    nodes/topics, physical links with their connectors and cables, power rails, MCU
    states, startup gates -- and may not hold a number that design_params.yaml or
    the requirements yaml already owns. Where a diag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
    [drive_mcu_wiring.kicad_sch, system_wiring.kicad_sch]
2026-07-30 CAD created, all drivertrain hardware ordered
    [Buddy_BOM.xlsx, M4 Socket Head Thread-Locking Screw (12mm Length).step, Sonic Hub.SLDASM]
2026-08-01 Fabrication and arm approach decided (ADR-0008, ADR-0009)
    Chassis, mounts, and future arm structure will be printed in-house on a QIDI
    Plus 4. The binding requirement turned out to be chamber temperature, not build
    volume or price: motor mounts bolt to gearboxes running at the 8 A design limit,
    and PLA's ~60 C glass transition would let them creep at exactly that interface
    - a failure that presents as drifting odometry, not as a broken part. That
    forces ASA/PA-CF, which at ~280 mm part length needs an actively heated chamber.
    Passive-enclosure machines (Bambu P1S, Elegoo Centauri Carbon) and the smaller
    Prusa CORE One drop out on that requirement.
    Arms are cost-forced to printed structure +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
    [Buddy_BOM.xlsx]
2026-08-01 Jetson bring-up: ROS 2 Jazzy installed, zero-hardware drive stack verified
    The milestone is real on the actual robot computer: /cmd_vel -> buddy_base
    bridge -> real protocol bytes over a pty -> mock MCU state machine and wheel
    model -> /odom. Commanded 0.2 m/s, reported steady-state 0.2008 m/s (0.4%
    error), independently measured 0.1952 m/s (2.4%), and position held after
    commands stopped - confirming the 200 ms watchdog end to end through the real
    bridge rather than a unit test. Also the first time the C protocol and state
    machine tests have run anywhere but a dev machine; the 07-15 entry noted they
    could not run on Windows for want of a POSIX toolchain.
    Three failures worth keeping:
    setu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
2026-08-01 First silicon: drive MCU flashed, Jetson link verified at 0.49 ms
    The firmware runs on real hardware. Flashed a NUCLEO-G474RE from the Jetson over
    SSH; st-flash verified the write. Board self-identified as STM32G47x_G48x with
    ST-LINK V3J16 at 0483:374e - exactly what 99-buddy-robot.rules assumed, so
    /dev/buddy_drive_mcu appeared on first plug-in.
    verify_drive_mcu_link.py passes 13/13: telemetry at 102.0 Hz against a 100 Hz
    target, zero CRC and version errors over 204 frames, SAFE_IDLE with no fault
    bits, and PING/PONG 10/10 reporting firmware v0.1.0 / protocol v1, which
    exercises the version gate in drive_protocol.md rule 4. Measured round trip is
    0.48-0.61 ms, median 0.49 - roughly 330x ma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
    [verify_drive_mcu_link.py]
2026-08-01 Cross-device access: Jetson pulls from GitHub, Windows setup documented
    Working from two laptops was going to mean rsyncing from whichever one happened
    to have the current tree, which makes one machine implicitly authoritative and
    guarantees divergence. Instead the Jetson gets its own GitHub deploy key and
    pulls directly, so every machine is just a terminal into the robot and none of
    them is special.
    Adds connecting_to_buddy.md: the deploy-key setup, per-device SSH key generation
    for Windows PowerShell (which ships OpenSSH - no PuTTY), config stanzas for both
    platforms, the Wi-Fi MAC for a DHCP reservation, and the note that Windows mDNS
    is less reliable than macOS so venti.local may need a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
2026-08-01 Ignore colcon workspace artifacts
    install/ and log/ are generated by colcon build on the robot and were not
    ignored, so a git add -A on the Jetson would have committed the entire install
    tree. Surfaced when converting ~/Buddy_Robot from an rsync copy to a real
    checkout. Also ignores per-machine Claude Code settings.
2026-08-01 Harden odom parsing in the zero-hardware check
    ros2 topic echo writes operational chatter to stdout, not stderr - notably
    "A message was lost!!!" when DDS drops a sample. Taking head -1 captured that
    text as the measurement and reported a failure that was purely a parsing
    artefact; the independent distance-based cross-check passed in the same run,
    which is what gave it away. Surfaced once the real MCU was streaming telemetry
    at 100 Hz alongside the test and the box got busy.
    Filters to a numeric line via an odom_field helper used for every sample.
2026-08-01 Document the Jetson git checkout as configured
    The deploy key is registered and ~/Buddy_Robot is a real checkout on main
    tracking origin/main, so the doc no longer describes it as an rsync copy.
    Records the git init/master-branch trap: pull prints tracking advice and
    silently does nothing, so the robot looks up to date when it is not.
2026-08-01 Add bridge-vs-real-MCU verification
    The bridge has only ever talked to mock_mcu.py over a pty. This points the same
    code path at /dev/buddy_drive_mcu, which is where mock-vs-reality mismatches
    live. Safe with no drivers wired and no motors attached.
2026-08-01 Bridge: stop logging routine state transitions as faults
    FAULT_EVT is emitted on ANY state transition, not just faults - main.c sends it
    whenever state or fault_bits change, and drive_protocol.md documents it as "on
    transition". The bridge logged every one at WARN, so the first real run against
    silicon reported two "MCU fault events" that were the benign SAFE_IDLE->ARMED
    handover with bits=0x0000. Left as-is, the bench phase would be full of spurious
    warnings and a real fault would be indistinguishable from routine chatter.
    Also fixes a related misreport: the handler logged core.state_name(), which is
    whatever the last telemetry frame said, rather than the state carried in the
    event payload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
    [ros_bridge_node.py]
2026-08-01 Fix CMD_TIMEOUT latching forever in the safety state machine
    sm_tick documents the command watchdog as "a recoverable stop, not a latched
    fault" and drops to SAFE_IDLE rather than FAULT. But the BP_FAULT_CMD_TIMEOUT
    bit it sets had no clear path anywhere: MODE_CLEAR_FAULT only acts in FAULT
    state, which the watchdog deliberately does not enter. Once set, the bit was
    unreachable for the life of the MCU.
    Found on real hardware. A fresh bridge run inherited 0x0002 from the previous
    session and reported it in both ARMED and ACTIVE, so every state transition
    looked like a fault and a genuinely new timeout would have been
    indistinguishable from a stale one.
    ESTOP already had this right - sm_set_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
    [state_machine.c]
2026-08-01 Link check: distinguish recoverable CMD_TIMEOUT from latching faults
    The check asserted fault_bits == 0, which assumed a freshly booted MCU and
    failed the moment it ran after a bridge session had let the watchdog fire.
    CMD_TIMEOUT is by design a recoverable stop flag that clears on the next ARM,
    so it is masked out and reported as a note; any other bit still fails.
    [verify_drive_mcu_link.py]
2026-08-01 M04 milestone, and fix every broken link on the site
    The reporting trail had fallen behind the work: log entries and ADRs were
    current but there was no milestone report past M03 (system integration), and
    PROJECT_CONTEXT still described the firmware as "Compiles", which stopped being
    the interesting claim once it was running on a real G474.
    M04 covers commissioning: Jetson bring-up, first flash, the measured link
    (102 Hz telemetry, 0.49 ms round trip, ~330x margin on the watchdog), the ROS
    bridge driving real silicon, and the latched-CMD_TIMEOUT bug that twenty passing
    host tests could not catch because they all start from sm_init and the bug only
    exists across a session boundary.
    Rebuildin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
2026-08-01 Add UART error-recovery check and its figure
    Demonstrates the RX-dies-on-error bug on hardware before fixing it, and adds
    uart_rx_recovery.svg explaining why the interrupt chain cannot restart itself.
    [verify_uart_error_recovery.py]
2026-08-01 Re-arm UART RX after a blocking error (HAL_UART_ErrorCallback)
    RX is a self-re-arming chain: HAL_UART_Receive_IT arms one byte and
    HAL_UART_RxCpltCallback arms the next. Reading the G4 HAL source settles what
    breaks it - HAL_UART_IRQHandler splits errors two ways. FE/NE/PE are
    non-blocking and reception continues unaided; ORE and RTO are blocking, and
    HAL calls UART_EndRxTransfer() to disable the RX interrupts before invoking a
    weak, empty HAL_UART_ErrorCallback. Nothing re-armed, so an overrun would kill
    reception permanently while TX kept streaming telemetry - the MCU looks healthy
    and the Jetson gets blamed.
    Honest scope: I could not reproduce it. Injecting the FE/NE class (garbage at a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
    [hw.c, verify_uart_error_recovery.py]
2026-08-01 Log the UART finding: real, narrower than filed, unreproducible
    Adds the August log and marks the bench TODO done, with the scope correction
    recorded rather than quietly dropped.
2026-08-01 Pin the build inputs that were silently machine-dependent
    The generated tree is committed, so an unpinned input never fails loudly - it
    just makes two machines disagree about bytes. Two such inputs were left open,
    and both were found by rebuilding this repo on a second machine.
    Fonts. MPL_SANS listed ["Helvetica Neue", "Helvetica", "Arial", "DejaVu Sans"],
    and matplotlib resolves that against the fonts INSTALLED ON THE BUILD MACHINE.
    macOS picked Helvetica Neue, Windows has none and fell through to Arial. Glyph
    widths set the text extents, bbox_inches="tight" sizes the canvas from those
    extents, and the result is baked into the committed SVG - 560.109531pt here
    versus 557.195pt there, from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
2026-08-01 Add sourced options for every unbought part, with two blockers found
    Researching actual products against the ADR constraints surfaced two problems
    that need a decision before anything is ordered.
    The Jetson 12V rail cannot work as specified. SHOPPING_LIST_v0_1 calls for a
    12V BUCK, but a step-down needs input above output and the 3S bus is 12.6V only
    at full charge, spending most of its discharge below 12V and bottoming at 9.0V.
    The named example part (D24V50F12) also does not appear to exist - Pololu 12V
    step-downs are 500mA, and the 5A D24V50F5 is a 5V part. Options are a real
    buck-boost (Pololu 12V buck-boost is only 2.5A against a 30W = 2.5A allocation,
    so a 10A class module is needed),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
2026-08-01 Change the bus to 4S LiFePO4 (ADR-0005 amendment 2)
    Compiling sourced options for the unbought parts found two problems that made
    the specified power architecture unbuildable.
    The Jetson 12 V rail could not exist. A step-down needs input above output, and
    a 3S bus is 12.6 V only at full charge, bottoming at 9.0 V. The named example
    part (D24V50F12) does not appear to exist either - Pololu fixed 12 V step-downs
    are 500 mA and the 5 A D24V50F5 is a 5 V part. That part number had been carried
    in the plan for three weeks.
    The >=50 A BMS was not purchasable in 3S. Stock 12 V Li-ion packs ship 10-30 A
    boards against a 46 A designed peak - a pack that trips on the first carpet
    pivot, which is wha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
    [system_wiring.kicad_sch]
2026-08-01 Define the chassis CAD interface, and a slot for measured inertia
    The chassis is the first part designed in CAD rather than in design_params.yaml,
    which creates a risk the rest of the repo does not have: two sources of truth for
    the same number - the YAML the URDF, Gazebo and the torque envelope believe,
    versus the model actually built. When those drift nothing errors; the simulation
    just describes a robot that does not exist. Same failure class as the Mermaid
    diagram deleted on 07-28 and the 0.08 m wheel radius in the deleted CAN stubs.
    chassis_interface.md draws the line. The YAML keeps owning anything the URDF,
    torque analysis, power model or a requirement consumes - track, wheelbase, wh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
    [base_four_wheel_diff.urdf.xacro, buddy_params.xacro]
2026-08-03 Add hand-turn encoder scaling verification
    encoder_counts_per_rev_output = 753.2 is the most suspect number in
    design_params.yaml: it was 4x wrong once already (2026-07-16, and every odometry
    estimate inherited the error), and the goBILDA datasheet carries a vendor error
    in the same table - its "(134.4 Cycles)" line is 7 x 19.2, which belongs to the
    19.2:1 motor rather than our 26.9:1. The yaml has said "verify empirically at
    bench" ever since.
    This is that check, and it needs no motor power at all. The encoder is a separate
    circuit from the windings, so the shaft is turned by hand and counts are read
    from the telemetry the firmware already sends at 100 Hz. Motor power leads stay
    disconnect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
    [design_params.yaml, verify_encoder_counts.py]
2026-08-03 Add mass_budget slots for measured component masses
    chassis.mass_kg was reverse-engineered so gross landed near the 20 kg ceiling -
    its own comment admitted it - which made the limit an assumption rather than a
    check. With real per-component masses here, structure mass comes from CAD and
    gross becomes derived, so every build re-checks the ceiling. That matters now:
    LiFePO4 cost ~+1.3 kg and printed structure is heavier than machined for the same
    stiffness.
    Wheel mass is deliberately absent - it already lives at wheels.mass_kg because
    the URDF consumes it for wheel-link inertia, and no value may exist twice. The
    rollup will read it from there.
    Each entry carries scale resolution, spread acr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
    [design_params.yaml]
2026-08-03 Encoder test: turn the wheel, not the bare shaft
    The procedure assumed the output shaft could be rotated by hand. It cannot - the
    26.9:1 planetary is being back-driven, so one output turn spins the rotor 26.9
    times against cogging torque, and gearboxes are far less efficient backwards.
    Fitting the hub and wheel gives 48 mm of radius against about 4 mm of finger grip
    on the REX hex, roughly 12x the torque for the same effort.
    Also notes two things that masquerade as faults: shorted motor leads brake the
    motor electrically and feel like a seized gearbox, and a slipping hub makes the
    count read low in a way that looks exactly like a gear-ratio error.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
    [design_params.yaml, verify_encoder_counts.py]
2026-08-03 Verify encoder scaling on hardware; give the sign convention a home
    Five hand turns of a wheel-mounted LF motor: 3753 counts = 750.6 per output rev
    against the 753.2 in design_params, -0.3%. That residual is 13 counts across 5
    turns, roughly 1.2 degrees of pen-mark alignment per turn - measurement error,
    not disagreement. The number is now measured rather than inferred.
    The 4x reading did not occur, which was the point. goBILDA documents "28 Pulses
    per Rotation (7 Cycles)" and carries a companion "(134.4 Cycles)" line that is a
    vendor error, since 134.4 = 7 x 19.2 belongs to the 19.2:1 motor. That ambiguity
    made 3013 counts/rev plausible, and reading it the wrong way is the bug that
    shipped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
    [build.py, design_params.yaml, hw.c]
2026-08-03 Mass budget: per-unit x count everywhere, no total fields
    motor_drivers_kg was defined as a 4x TOTAL and held a single-driver measurement,
    under-reporting by 33 g. Rather than correct the value, remove the shape that
    allowed it: everything in components is now per unit with an explicit count, so a
    per-unit reading can no longer land in a total field.
    Jetson, drive MCU and motor drivers move from pending into components since they
    are in hand. The Jetson entry states what was on the scale - dev kit as mounted,
    carrier plus module plus heatsink and fan - because "the Jetson" is ambiguous
    between the module and the kit, and standoffs belong to a fasteners line.
    Subtotal so far 2.931 kg, with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
    [design_params.yaml]
